sieraczynski-lab/Williamson-KT88/docs/01-lampy-kt88.md

# Lampy KT88 Psvane: serie i różnice

Elektrycznie wszystkie Psvane KT88 to wciąż KT88: anoda do ok. 35–42 W, napięcie anodowe do 800 V, żarzenie 6,3 V / 1,6 A. Pasują do tego samego układu bez przeliczania. Różnią się konstrukcją, selekcją, wyglądem i ceną. Psvane wywodzi się z działu lamp high-end fabryki Shuguang (seria Black Treasure to też Shuguang).

## Serie, od najtańszej do najdroższej (orientacyjnie)

| Seria | Co to jest | Cena orientacyjna |
|---|---|---|
| **AIR KT88** | najnowsza, budżetowa | ok. 70 € / szt. (Audiophonics) |
| **KT88 / KT88C Classic** | podstawowa wersja Hi-Fi | – |
| **KT88-T / KT88-TII (Mark II)** | szara powłoka węglowa wewnątrz bańki, teflonowy cokół z aluminiowym pierścieniem, grubsze szkło (ok. 10% cięższa) | ok. 449 € za dobrany kwartet |
| **UK-KT88** | wygląd nawiązujący do klasycznych GEC/Genalex | – |
| **Art (np. KT88-T3, ART TIII)** | średnio-wysoka półka | – |
| **Cossor KT88-R** | seria „retro”, też z niebieskawym szkłem | ok. 170 USD za parę, 340 USD za kwartet (eBay, sprzedawcy z Chin) |
| **ACME KT88** | były flagowiec: selekcja 3–5% najlepszych z partii, min. 24 h wygrzewania, ceramiczny cokół, złocone piny | ok. 119 CHF / szt. |
| **Summit KT88** | obecny flagowiec, wielowarstwowa powłoka katody HPC | ok. 655 USD za kwartet |

Opinie brzmieniowe (np. ACME „neutralna, dynamiczna”, ART TIII w 6SN7 „bardziej przytłumiona niż Summit”) pochodzą z pojedynczych recenzji i forów. Traktować je jako subiektywne.

## Niezawodność

Na forach (WhatsBestForum, Audiogon) są pojedyncze relacje o awariach: KT88C po 3 tygodniach, TII po 400 godzinach. To anegdoty, nie statystyka, ale wyższa seria nie gwarantuje automatycznie trwałości. Lepiej kupować u dealera z gwarancją i realnym parowaniem. Na eBayu od przypadkowych sprzedawców jest ryzyko podróbek.

## Wnioski dla projektu

- Do pierwszego uruchomienia i strojenia wziąć tańszą serię (AIR, Classic, TII). Podczas szukania oscylacji i ustawiania biasu lampy dostają w kość.
- Kupować **parę dobraną fabrycznie** (po dwie na kanał). Przy toroidzie i tak potrzebna jest osobna regulacja biasu każdej lampy.
- Droższe serie (Summit, ACME, Cossor) porównywać dopiero na dostrojonym wzmacniaczu. Wtedy różnice będą wynikały z lamp, a nie z układu.
