sieraczynski-lab/Williamson-KT88/obudowa/widok_plytka.png

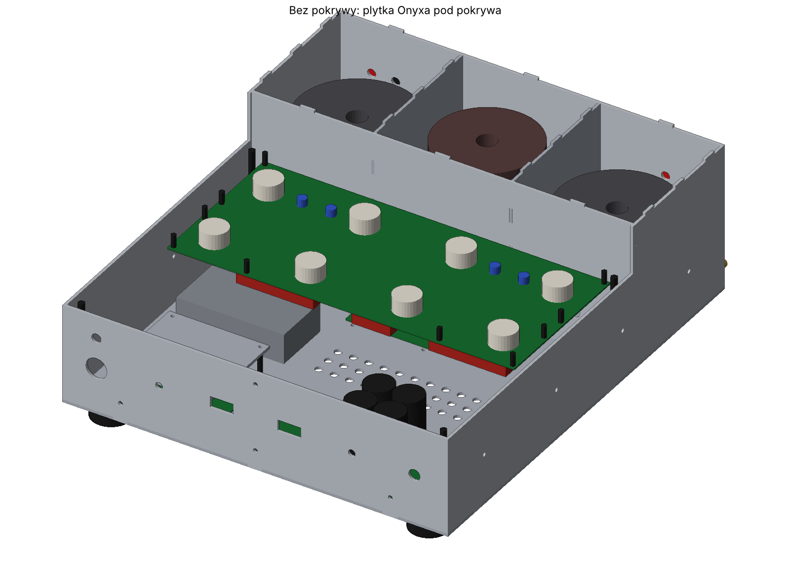
obudowa/widok_plytka.png
