sieraczynski-lab/Williamson-KT88/obudowa/widok_tyl.png

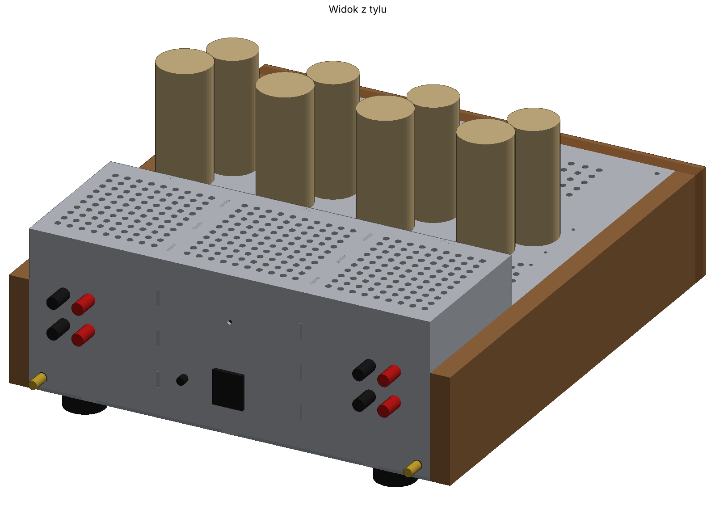
obudowa/widok_tyl.png
