sieraczynski-lab/Williamson-KT88/obudowa/widok_wnetrze.png

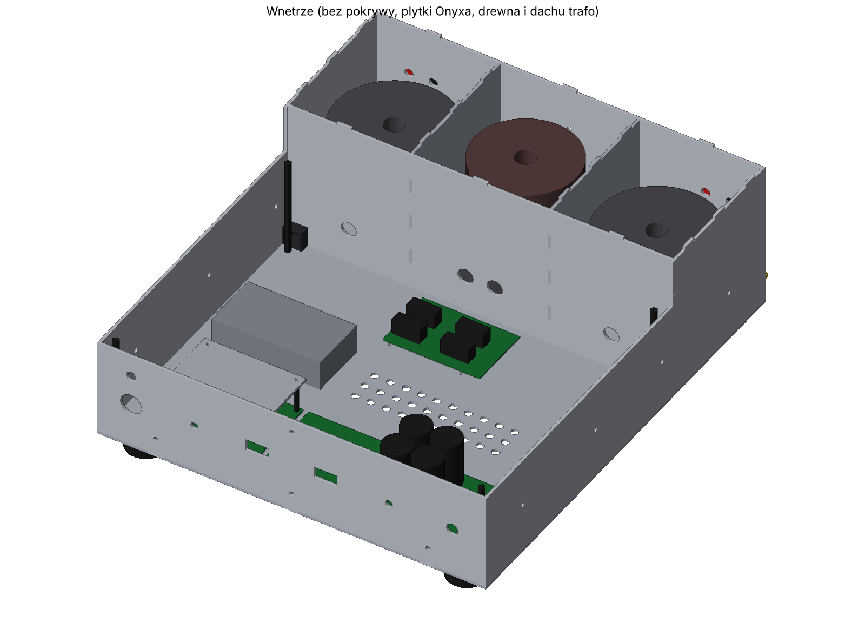
obudowa/widok_wnetrze.png
