sieraczynski-lab/Williamson-KT88/pcb/glosniki/glosniki_rozmieszczenie.png

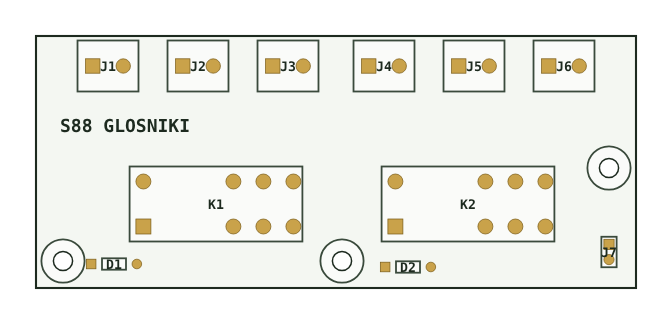
pcb/glosniki/glosniki_rozmieszczenie.png
