sieraczynski-lab/Williamson-KT88/pcb/sterowanie/sterowanie_rozmieszczenie.png

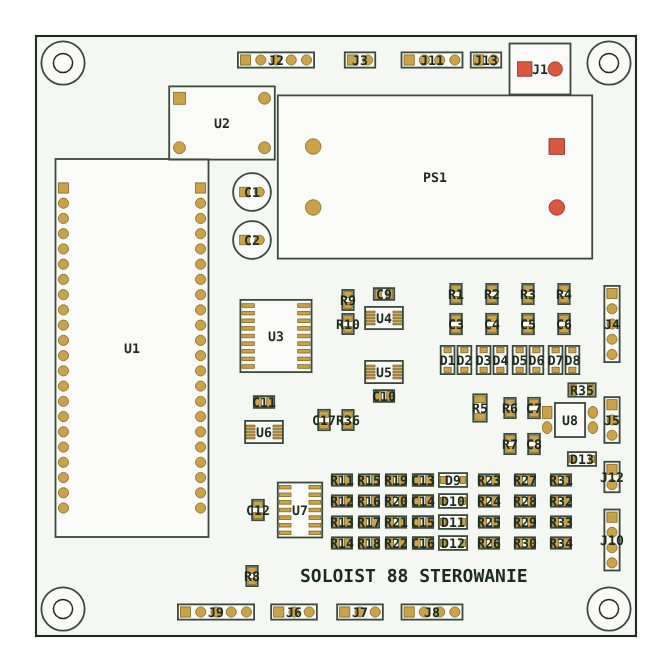
pcb/sterowanie/sterowanie_rozmieszczenie.png
