sieraczynski-lab/Williamson-KT88/pcb/ul/ul_trioda_williamson_rozmieszczenie.png

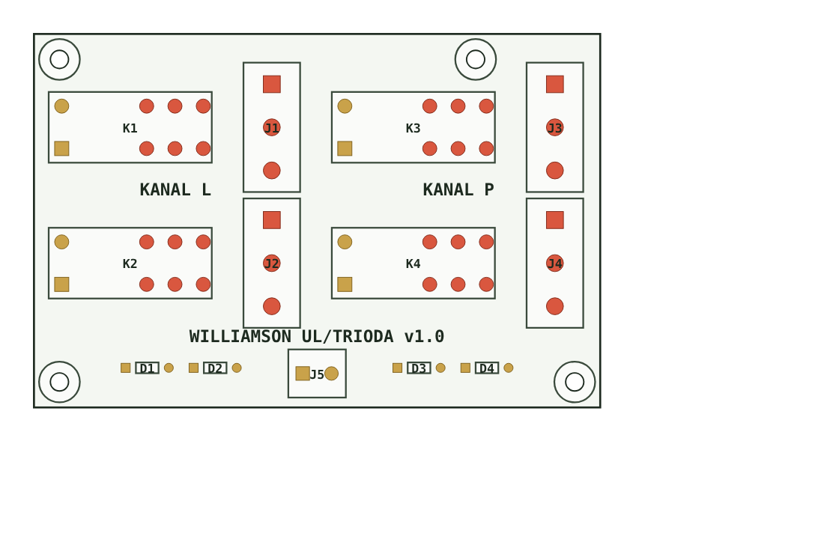
pcb/ul/ul_trioda_williamson_rozmieszczenie.png
