sieraczynski-lab/Williamson-KT88/pcb/ul/ul_trioda_williamson_schemat.png

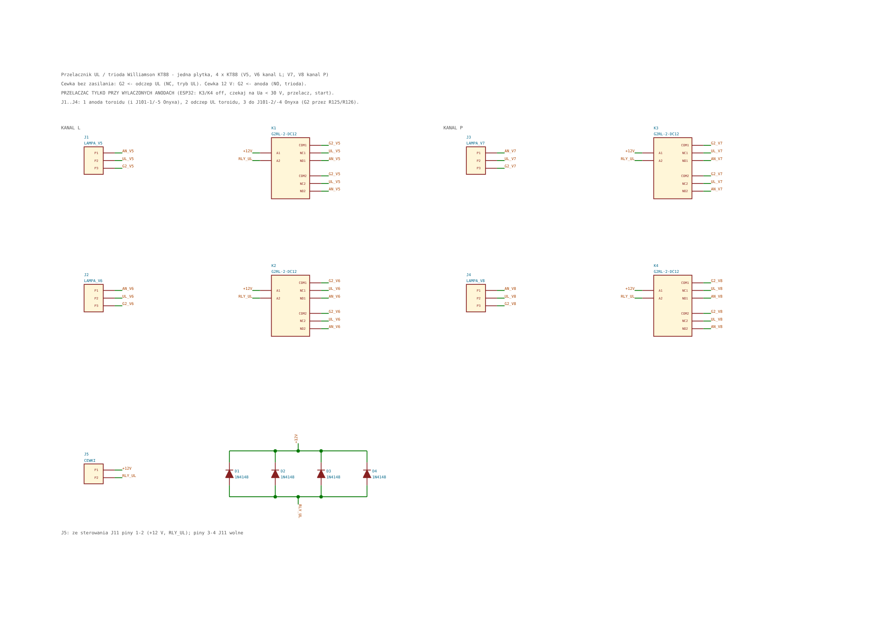
pcb/ul/ul_trioda_williamson_schemat.png
