sieraczynski-lab/Williamson-KT88/pcb/zasilacz/zasilacz_williamson_schemat.png

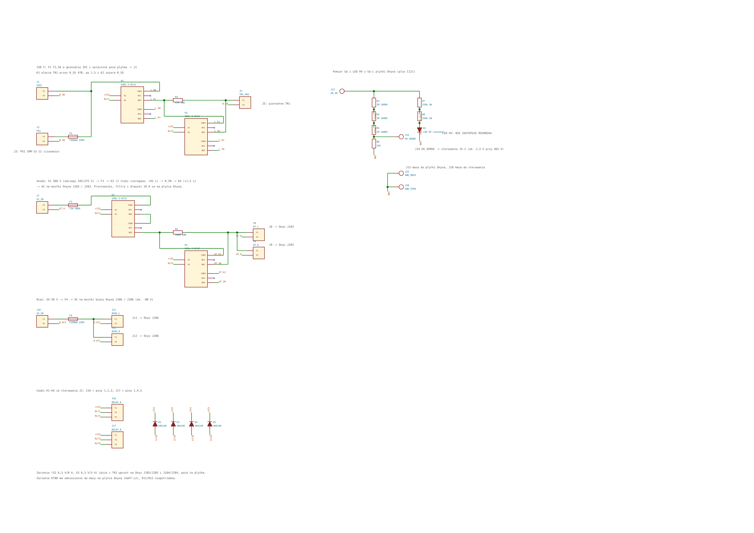
pcb/zasilacz/zasilacz_williamson_schemat.png
