sieraczynski-lab/Williamson-KT88/pcb/glosniki/glosniki_BOM_LCSC.xlsx

Soloist 88 - BOM plytki glosniki (x1) - elementy przewlekane
Czesci wybrane z czesci DOSTEPNYCH na magazynie wg bazy katalogu JLCPCB/LCSC z 25.10.2026 (kolumna Stan). Wiersze na pomaranczowo = brak w LCSC, kup w TME / sklepie lampowym. Minimalne ilosci sprawdz w koszyku.
Lp | Oznaczenia | Ilosc na plytke | Liczba plytek | Ilosc razem | Opis / parametry | Obudowa / raster | Producent | MPN | LCSC | Stan mag. (25.10) | Uwagi / gdzie kupic
1 | D1, D2 | 2 | 1 | 2 | Dioda 1N4148 | DO-35 |  | 1N4148 | C402212 | 162903
2 | J1, J2, J3, J4, J5, J6 | 6 | 1 | 6 | Zlacze srubowe 2-pin 5,08 mm |  | KEFA | KF128-5.08-2P-AA | C474952 | 62181
3 | K1, K2 | 2 | 1 | 2 | Przekaznik Omron G2RL-2 12 V DPDT 8 A | 29 x 12,7 mm |  | G2RL-2-DC12 | C61458 | 1258 | przed zamowieniem plytek sprawdz piny (CZYTAJ_MNIE)
4 | listwy proste (2 pin) | 1 | 1 | 1 | Listwa kolkowa prosta 1x40, 2,54 mm (do ciecia) | 2,54 mm |  | 2.54-1*40P | C2337 | 73249 | potrzeba 2 pinow + wtyki
