sieraczynski-lab/Williamson-KT88/obudowa/DXF/AL_dno_400x460x3.dxf

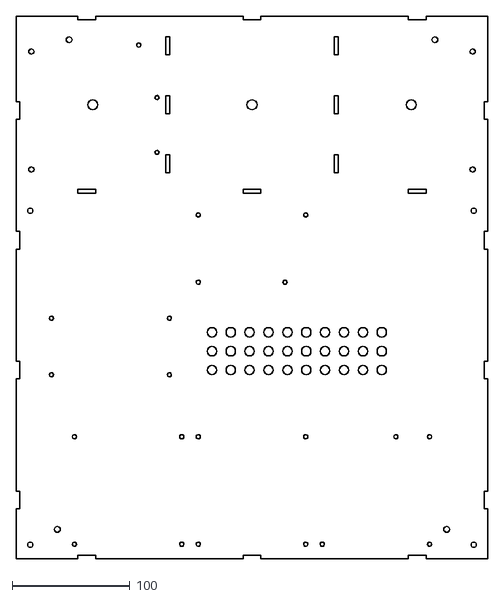
[picture p14: CAD file, 2026-11-13]
obudowa/DXF/AL_dno_400x460x3.dxf
400.0 x 460.0
