sieraczynski-lab/Williamson-KT88/obudowa/Williamson_obudowa_z_elementami.step

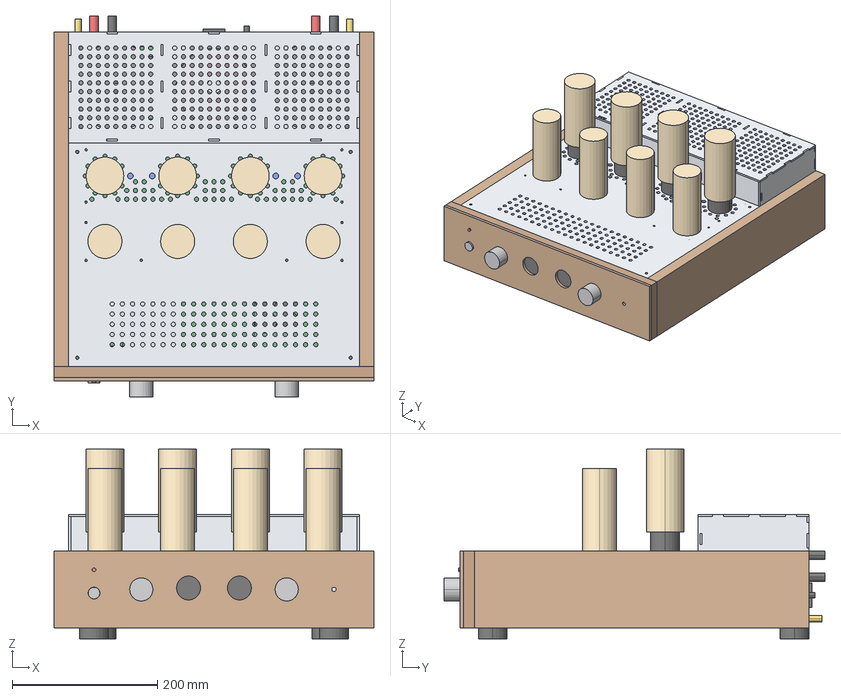
[picture p15: CAD file, 2026-11-13]
obudowa/Williamson_obudowa_z_elementami.step
440.0 x 524.0 x 261.0 mm
AL_dno_400x460x3
AL_bok_lewy
AL_bok_prawy
AL_przod_wewn
AL_trafo_przod
AL_trafo_tyl
AL_trafo_przegroda_L
AL_trafo_przegroda_P
AL_trafo_dach
AL_pokrywa_gorna
ST_profil_20x20x1.5_L_dl157
ST_profil_20x20x1.5_P_dl157
AL_ekran_sterowania
DREWNO_front_lico_5mm
DREWNO_front_rama_15mm
DREWNO_bok_lewy
DREWNO_bok_prawy
REF_plytka_Onyx_VA1523
REF_tuleja_M3_13mm x 10
REF_podstawka_oktal x 8
REF_KT88_cokol x 4
REF_KT88_banka x 4
REF_V1_L_6SN7_butelka
REF_V2_L_6SN7_butelka
REF_V2_R_6SN7_butelka
REF_V1_R_6SN7_butelka
REF_kondensatory_pod_plytka_0
REF_kondensatory_pod_plytka_1
REF_kondensatory_pod_plytka_2
REF_kondensatory_pod_plytka_3
REF_kondensatory_pod_plytka_4
REF_potencjometr_biasu x 4
REF_plytka_UL_LP
REF_przekaznik_G2RL_UL x 4
REF_selektor_puszka_1590
REF_plytka_sterowanie
REF_plytka_zasilacz_siec
REF_plytka_zasilacz_hv
REF_C_snapin_0
REF_C_snapin_1
REF_C_snapin_2
REF_C_snapin_3
REF_OT_L
REF_tuleja_TG_35mm x 2
REF_TR1
REF_OT_R
REF_gniazdo_RCA x 2
REF_tulejka_M3_ekran x 4
REF_dlawik_L1
REF_tulejka_M4_100mm x 4
REF_noga x 4
REF_galka x 2
REF_przycisk
REF_LED_2kol
REF_wyswietlacz_okragly x 2
REF_zacisk_glosnikowy x 8
REF_gniazdo_trigger_3.5mm
REF_plytka_glosniki
REF_przekaznik_G2RL x 2
REF_gniazdo_IEC
