sieraczynski-lab/Williamson-KT88/obudowa/DXF/AL_pokrywa_gorna.dxf

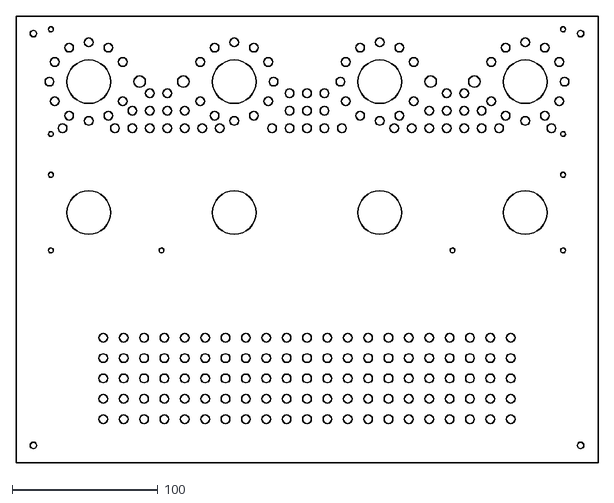
[picture p16: CAD file, 2026-11-12]
obudowa/DXF/AL_pokrywa_gorna.dxf
400.0 x 307.0
