sieraczynski-lab/Williamson-KT88/obudowa/Williamson_obudowa.step

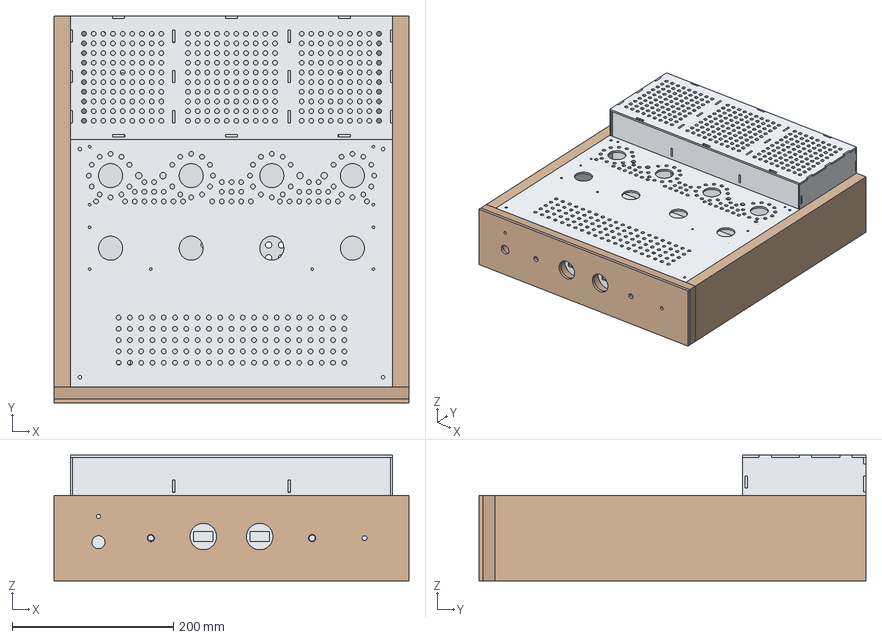
[picture p17: CAD file, 2026-11-13]
obudowa/Williamson_obudowa.step
440.0 x 480.0 x 156.0 mm
AL_dno_400x460x3
AL_bok_lewy
AL_bok_prawy
AL_przod_wewn
AL_trafo_przod
AL_trafo_tyl
AL_trafo_przegroda_L
AL_trafo_przegroda_P
AL_trafo_dach
AL_pokrywa_gorna
ST_profil_20x20x1.5_L_dl157
ST_profil_20x20x1.5_P_dl157
AL_ekran_sterowania
DREWNO_front_lico_5mm
DREWNO_front_rama_15mm
DREWNO_bok_lewy
DREWNO_bok_prawy
