sieraczynski-lab/Williamson-KT88/obudowa/DXF/AL_trafo_tyl.dxf

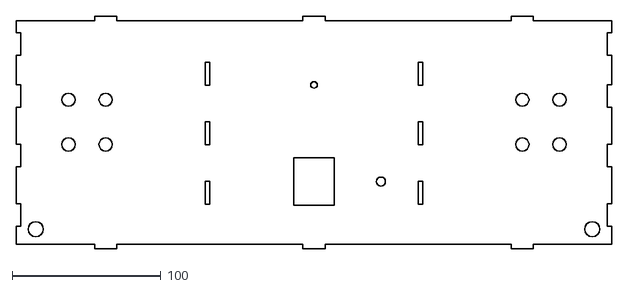
[picture p18: CAD file, 2026-11-12]
obudowa/DXF/AL_trafo_tyl.dxf
400.0 x 156.0
