sieraczynski-lab/Williamson-KT88/obudowa/DXF/AL_trafo_przegroda_L.dxf

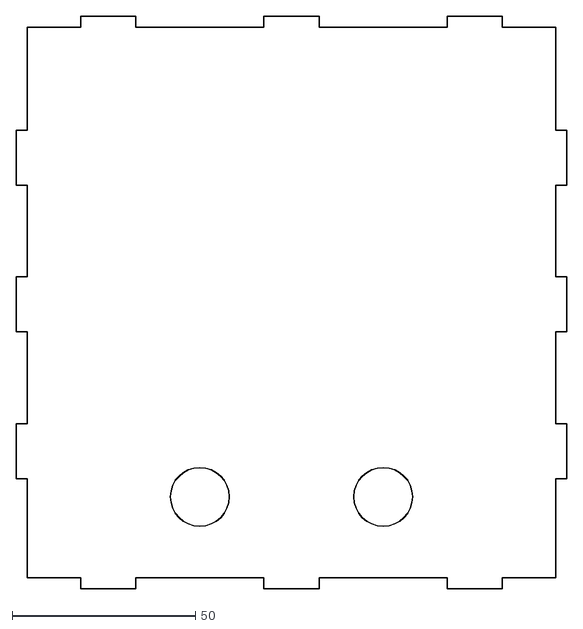
[picture p19: CAD file, 2026-11-12]
obudowa/DXF/AL_trafo_przegroda_L.dxf
150.0 x 156.0
