sieraczynski-lab/Williamson-KT88/obudowa/DXF/DREWNO_front_lico_5mm.dxf

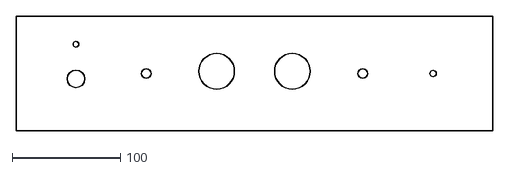
[picture p20: CAD file, 2026-11-12]
obudowa/DXF/DREWNO_front_lico_5mm.dxf
440.0 x 106.0
