sieraczynski-lab/Williamson-KT88/obudowa/DXF/AL_ekran_sterowania.dxf

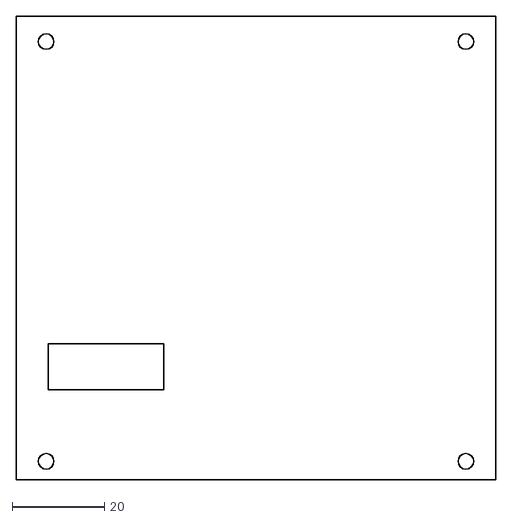
[picture p21: CAD file, 2026-11-12]
obudowa/DXF/AL_ekran_sterowania.dxf
104.0 x 100.5
