sieraczynski-lab/Williamson-KT88/obudowa/DXF/DREWNO_bok_lewy.dxf

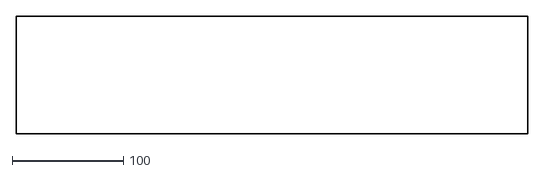
[picture p22: CAD file, 2026-11-12]
obudowa/DXF/DREWNO_bok_lewy.dxf
460.0 x 106.0
