sieraczynski-lab/Williamson-KT88/obudowa/DXF/AL_trafo_dach.dxf

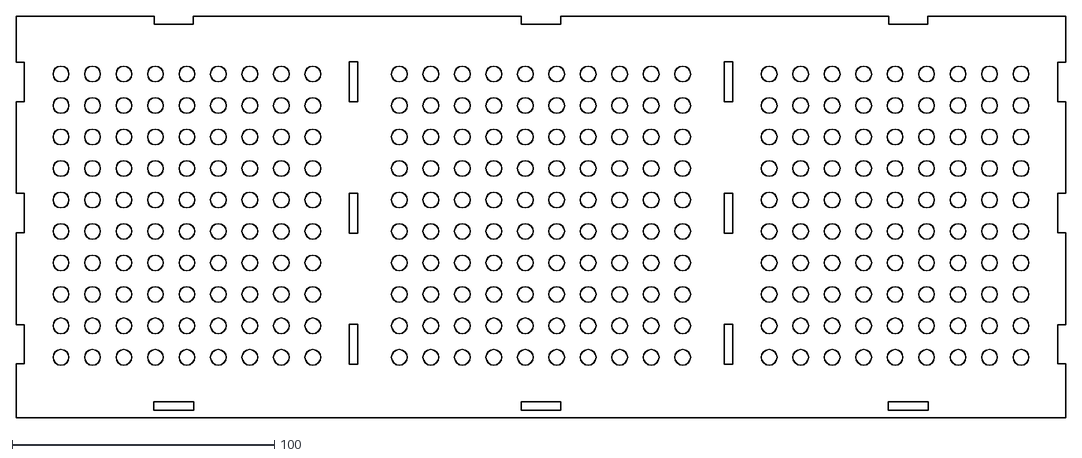
[picture p23: CAD file, 2026-11-12]
obudowa/DXF/AL_trafo_dach.dxf
400.0 x 153.0
