sieraczynski-lab/Williamson-KT88/obudowa/DXF/AL_przod_wewn.dxf

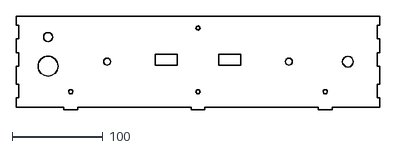
[picture p24: CAD file, 2026-11-12]
obudowa/DXF/AL_przod_wewn.dxf
400.0 x 103.0
