sieraczynski-lab/Williamson-KT88/obudowa/DXF/AL_bok_prawy.dxf

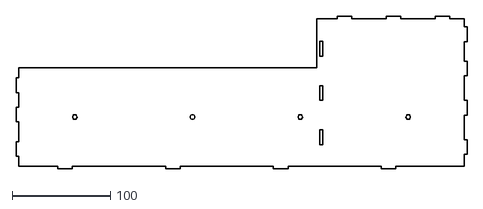
[picture p25: CAD file, 2026-11-12]
obudowa/DXF/AL_bok_prawy.dxf
460.0 x 156.0
