sieraczynski-lab/Williamson-KT88/obudowa/DXF/AL_trafo_przod.dxf

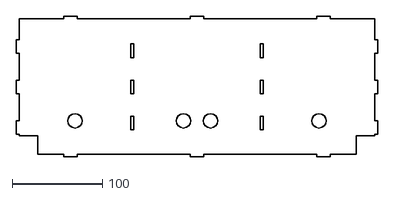
[picture p26: CAD file, 2026-11-12]
obudowa/DXF/AL_trafo_przod.dxf
400.0 x 156.0
