sieraczynski-lab/Williamson-KT88/obudowa/DXF/DREWNO_front_rama_15mm.dxf

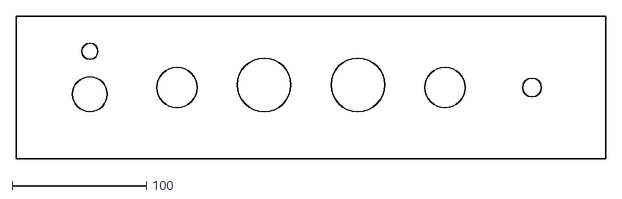
[picture p27: CAD file, 2026-11-12]
obudowa/DXF/DREWNO_front_rama_15mm.dxf
440.0 x 106.0
