sieraczynski-lab/Williamson-KT88/pcb/glosniki/glosniki_rozmieszczenie_1do1.pdf

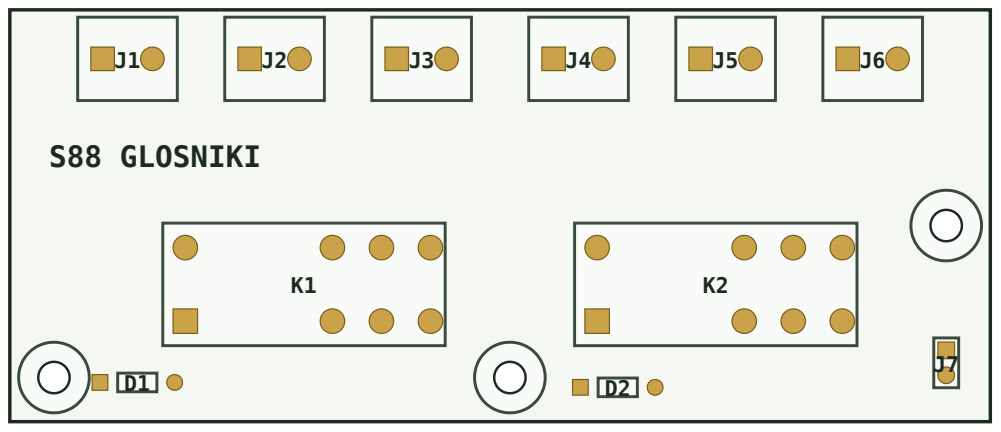
[picture p28: page 1]
