sieraczynski-lab/Williamson-KT88/pcb/sterowanie/sterowanie_rozmieszczenie_1do1.pdf

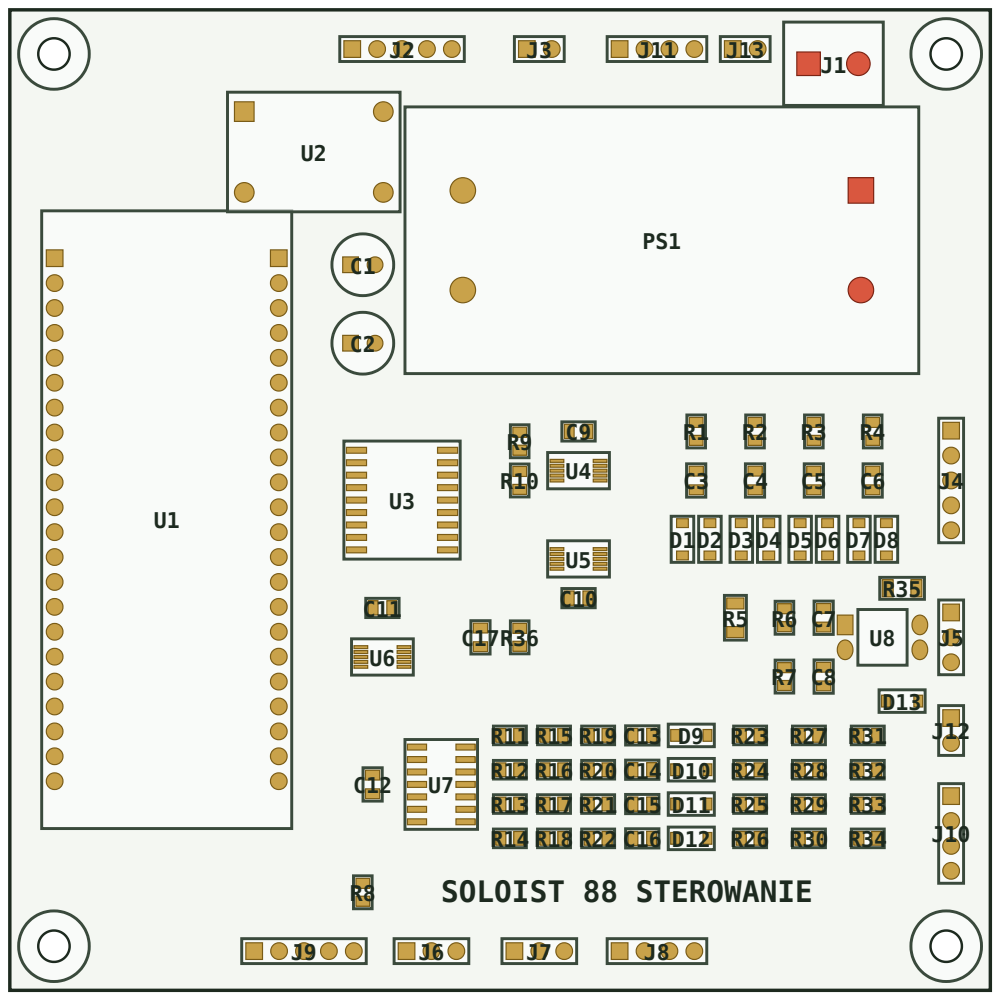
[picture p29: page 1]
