sieraczynski-lab/Williamson-KT88/pcb/ul/KiCad5_dla_EasyEDA_Pro_i_KiCad8/ul_trioda_williamson.kicad_pcb

## KiCad design pcb/ul/KiCad5_dla_EasyEDA_Pro_i_KiCad8/ul_trioda_williamson.kicad_pcb (2026-11-13)

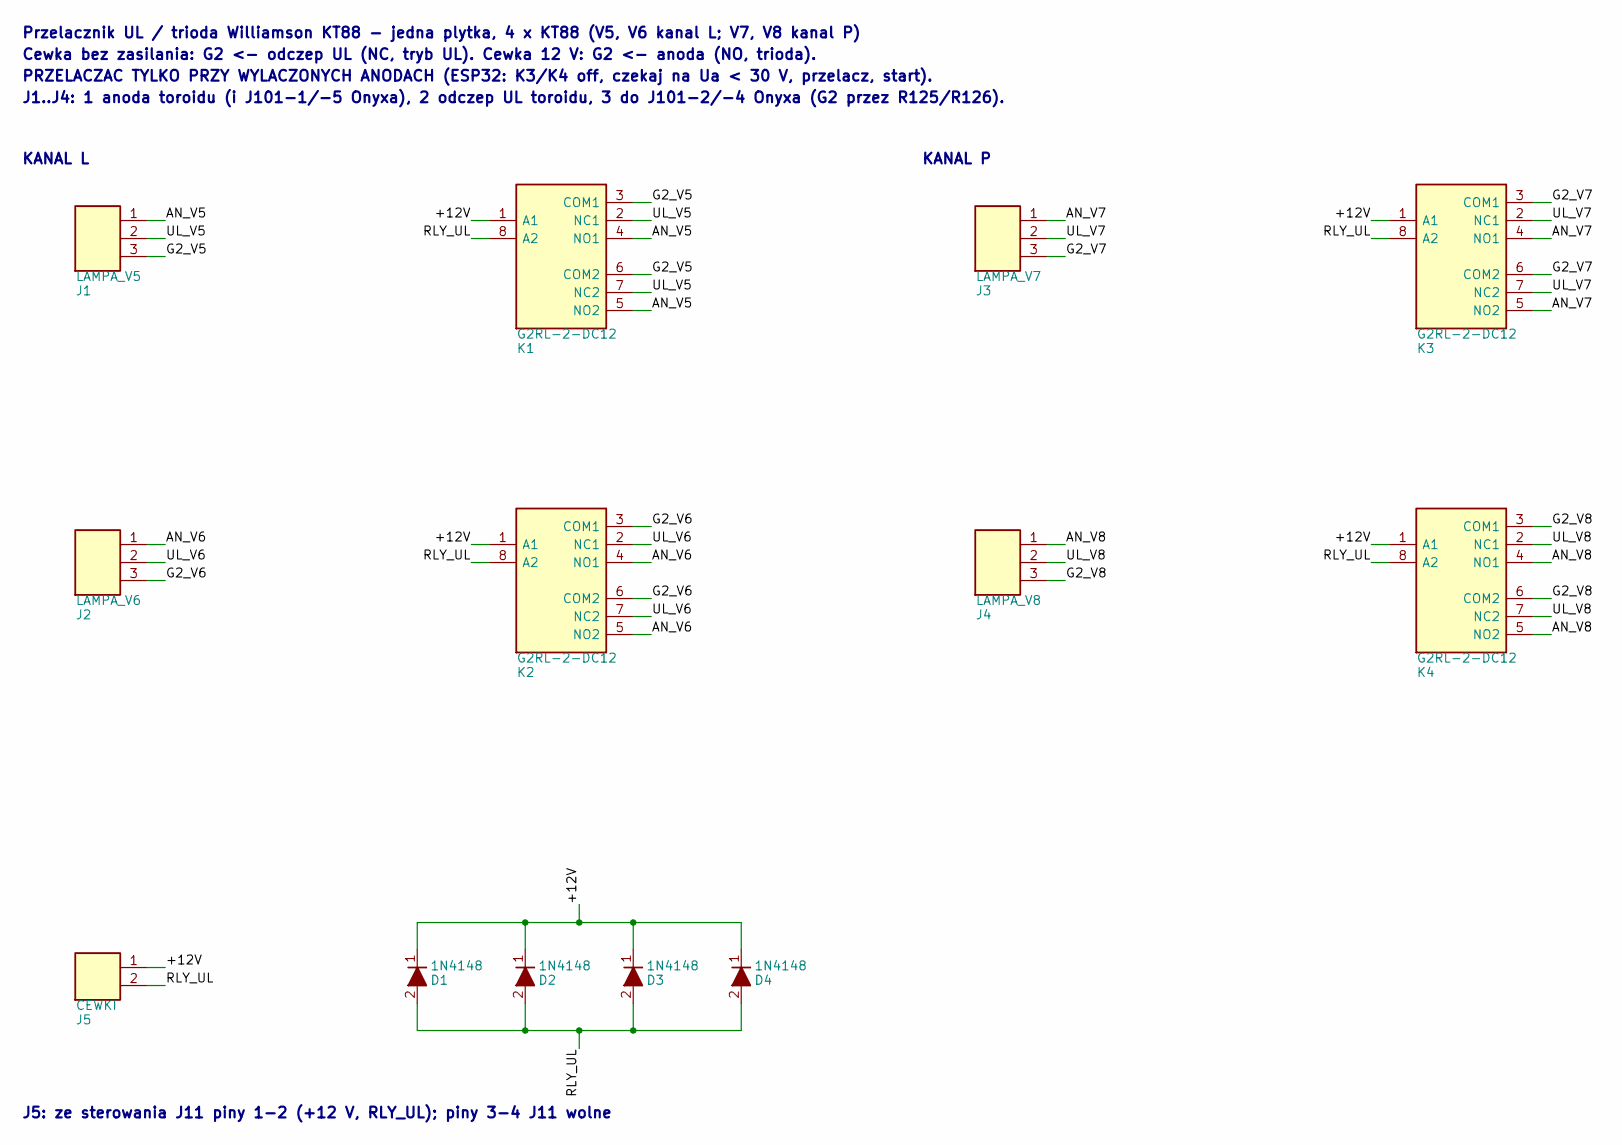
[picture p30: schematic ul_trioda_williamson.sch, Williamson KT88 - przelacznik UL/trioda, 4x KT88 na jednej …]

Parts:
D1, D2, D3, D4: 1N4148; D_DO-35_P7.62
J1: LAMPA_V5; TerminalBlock_1x03_P7.62_V
J2: LAMPA_V6; TerminalBlock_1x03_P7.62_V
J3: LAMPA_V7; TerminalBlock_1x03_P7.62_V
J4: LAMPA_V8; TerminalBlock_1x03_P7.62_V
J5: CEWKI; TerminalBlock_1x02_P5.08
K1, K2, K3, K4: G2RL-2-DC12; Relay_DPDT_Omron_G2RL

Connections:
+12V: D1.1 (K), D2.1 (K), D3.1 (K), D4.1 (K), J5.1, K1.1 (A1), K2.1 (A1), K3.1 (A1), K4.1 (A1)
AN_V5: J1.1, K1.4 (NO1), K1.5 (NO2)
AN_V6: J2.1, K2.4 (NO1), K2.5 (NO2)
AN_V7: J3.1, K3.4 (NO1), K3.5 (NO2)
AN_V8: J4.1, K4.4 (NO1), K4.5 (NO2)
G2_V5: J1.3, K1.3 (COM1), K1.6 (COM2)
G2_V6: J2.3, K2.3 (COM1), K2.6 (COM2)
G2_V7: J3.3, K3.3 (COM1), K3.6 (COM2)
G2_V8: J4.3, K4.3 (COM1), K4.6 (COM2)
RLY_UL: D1.2 (A), D2.2 (A), D3.2 (A), D4.2 (A), J5.2, K1.8 (A2), K2.8 (A2), K3.8 (A2), K4.8 (A2)
UL_V5: J1.2, K1.2 (NC1), K1.7 (NC2)
UL_V6: J2.2, K2.2 (NC1), K2.7 (NC2)
UL_V7: J3.2, K3.2 (NC1), K3.7 (NC2)
UL_V8: J4.2, K4.2 (NC1), K4.7 (NC2)

Notes on the sheet:
Przelacznik UL / trioda Williamson KT88 - jedna plytka, 4 x KT88 (V5, V6 kanal L; V7, V8 kanal P)
Cewka bez zasilania: G2 <- odczep UL (NC, tryb UL). Cewka 12 V: G2 <- anoda (NO, trioda).
PRZELACZAC TYLKO PRZY WYLACZONYCH ANODACH (ESP32: K3/K4 off, czekaj na Ua < 30 V, przelacz, start).
J1..J4: 1 anoda toroidu (i J101-1/-5 Onyxa), 2 odczep UL toroidu, 3 do J101-2/-4 Onyxa (G2 przez R125/R126).
KANAL L
KANAL P
J5: ze sterowania J11 piny 1-2 (+12 V, RLY_UL); piny 3-4 J11 wolne

Board: 2 copper layers, 17 parts (0 on the bottom side), 14 nets, no tracks yet.

Other parts of the board:
MH1, MH2, MH3, MH4: M3; MountingHole_M3
