sieraczynski-lab/Williamson-KT88/pcb/zasilacz/KiCad4_dla_EasyEDA_Standard/zasilacz_williamson.kicad_pcb

## KiCad design pcb/zasilacz/KiCad4_dla_EasyEDA_Standard/zasilacz_williamson.kicad_pcb (2026-11-12)

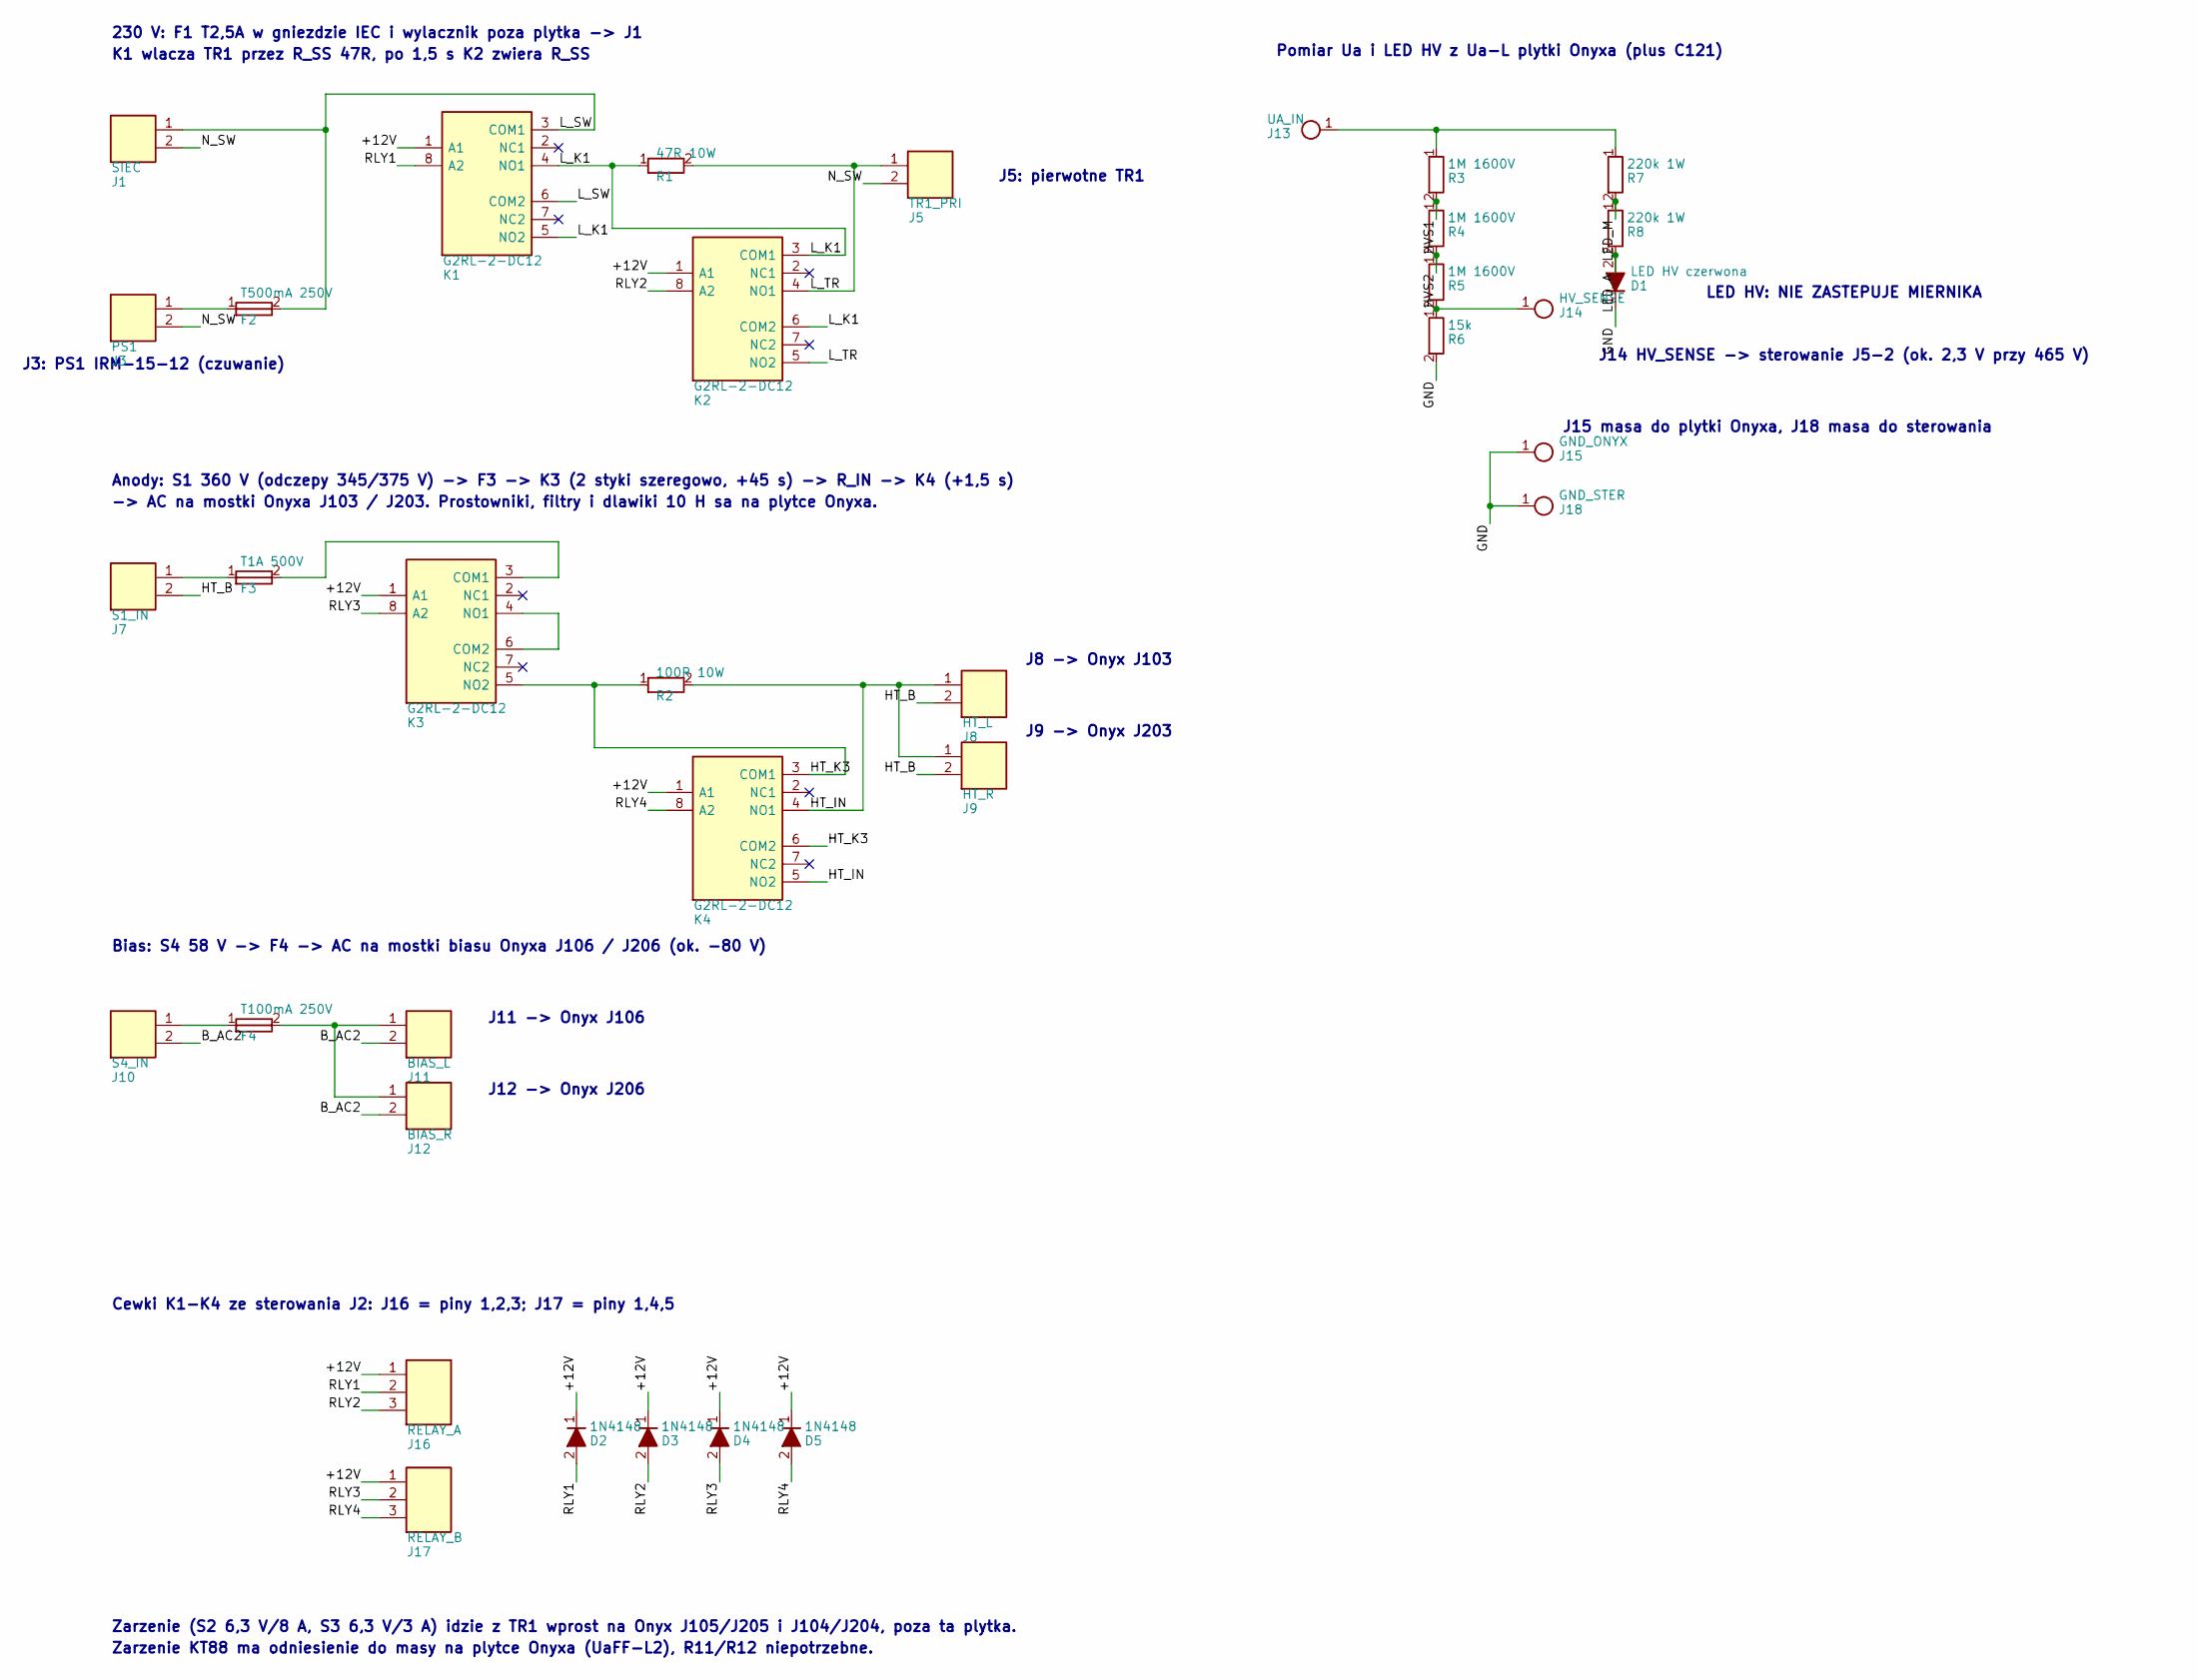
[picture p31: schematic zasilacz_williamson.sch, Williamson KT88 - plytka zasilacza (siec, opoznienie anod, …]

Parts:
D1: LED HV czerwona; LED_D3.0_P2.54
D2, D3, D4, D5: 1N4148; D_DO-35_P7.62_V
F2: T500mA 250V; Fuseholder_5x20_Closed_P22.5
F3: T1A 500V; Fuseholder_5x20_Closed_P22.5_V
F4: T100mA 250V; Fuseholder_5x20_Closed_P22.5
J1: SIEC; TerminalBlock_1x02_P5.08_V
J3: PS1; TerminalBlock_1x02_P5.08_V
J5: TR1_PRI; TerminalBlock_1x02_P5.08_V
J7: S1_IN; TerminalBlock_1x02_P7.62_V
J8: HT_L; TerminalBlock_1x02_P7.62_V
J9: HT_R; TerminalBlock_1x02_P7.62_V
J10: S4_IN; TerminalBlock_1x02_P5.08_V
J11: BIAS_L; TerminalBlock_1x02_P5.08
J12: BIAS_R; TerminalBlock_1x02_P5.08
J13: UA_IN; WirePad_4.5
J14: HV_SENSE; WirePad_3.5
J15: GND_ONYX; WirePad_4.5
J16: RELAY_A; PinHeader_1x03_P2.54
J17: RELAY_B; PinHeader_1x03_P2.54
J18: GND_STER; WirePad_3.5
K1, K2, K3, K4: G2RL-2-DC12; Relay_DPDT_Omron_G2RL
R1: 47R 10W; R_Cement_10W_P55.88_V
R2: 100R 10W; R_Cement_10W_P55.88_V
R3, R4, R5: 1M 1600V; R_Axial_1W_P15.24_V
R6: 15k; R_Axial_0.5W_P12.7_V
R7, R8: 220k 1W; R_Axial_1W_P15.24_V

Connections:
+12V: D2.1 (K), D3.1 (K), D4.1 (K), D5.1 (K), J16.1, J17.1, K1.1 (A1), K2.1 (A1), K3.1 (A1), K4.1 (A1)
B_AC1: F4.1, J10.1
B_AC2: J10.2, J11.2, J12.2
B_F: F4.2, J11.1, J12.1
GND: D1.1 (K), J15.1, J18.1, R6.2
HT_B: J7.2, J8.2, J9.2
HT_F: F3.2, K3.3 (COM1)
HT_IN: J8.1, J9.1, K4.4 (NO1), K4.5 (NO2), R2.2
HT_K3: K3.5 (NO2), K4.3 (COM1), K4.6 (COM2), R2.1
HT_TR: F3.1, J7.1
HVS1: R3.2, R4.1
HVS2: R4.2, R5.1
HV_SENSE: J14.1, R5.2, R6.1
K3_MID: K3.4 (NO1), K3.6 (COM2)
LED_A: D1.2 (A), R8.2
LED_M: R7.2, R8.1
L_K1: K1.4 (NO1), K1.5 (NO2), K2.3 (COM1), K2.6 (COM2), R1.1
L_SW: F2.2, J1.1, K1.3 (COM1), K1.6 (COM2)
L_TR: J5.1, K2.4 (NO1), K2.5 (NO2), R1.2
L_TR2: F2.1, J3.1
N_SW: J1.2, J3.2, J5.2
RLY1: D2.2 (A), J16.2, K1.8 (A2)
RLY2: D3.2 (A), J16.3, K2.8 (A2)
RLY3: D4.2 (A), J17.2, K3.8 (A2)
RLY4: D5.2 (A), J17.3, K4.8 (A2)
UA: J13.1, R3.1, R7.1

Notes on the sheet:
230 V: F1 T2,5A w gniezdzie IEC i wylacznik poza plytka -> J1
K1 wlacza TR1 przez R_SS 47R, po 1,5 s K2 zwiera R_SS
J5: pierwotne TR1
J3: PS1 IRM-15-12 (czuwanie)
Anody: S1 360 V (odczepy 345/375 V) -> F3 -> K3 (2 styki szeregowo, +45 s) -> R_IN -> K4 (+1,5 s)
-> AC na mostki Onyxa J103 / J203. Prostowniki, filtry i dlawiki 10 H sa na plytce Onyxa.
J8 -> Onyx J103
J9 -> Onyx J203
Bias: S4 58 V -> F4 -> AC na mostki biasu Onyxa J106 / J206 (ok. -80 V)
J11 -> Onyx J106
J12 -> Onyx J206
Pomiar Ua i LED HV z Ua-L plytki Onyxa (plus C121)
J14 HV_SENSE -> sterowanie J5-2 (ok. 2,3 V przy 465 V)
J15 masa do plytki Onyxa, J18 masa do sterowania
LED HV: NIE ZASTEPUJE MIERNIKA
Cewki K1-K4 ze sterowania J2: J16 = piny 1,2,3; J17 = piny 1,4,5
Zarzenie (S2 6,3 V/8 A, S3 6,3 V/3 A) idzie z TR1 wprost na Onyx J105/J205 i J104/J204, poza ta plytka.
Zarzenie KT88 ma odniesienie do masy na plytce Onyxa (UaFF-L2), R11/R12 niepotrzebne.

Board: 2 copper layers, 39 parts (0 on the bottom side), 26 nets, no tracks yet.

Other parts of the board:
MH1, MH2, MH3, MH4: M3; MountingHole_M3
