sieraczynski-lab/Williamson-KT88/pcb/selektor/kicad/tube_selector.kicad_pcb

## KiCad design pcb/selektor/kicad/tube_selector.kicad_pcb (2026-11-12)

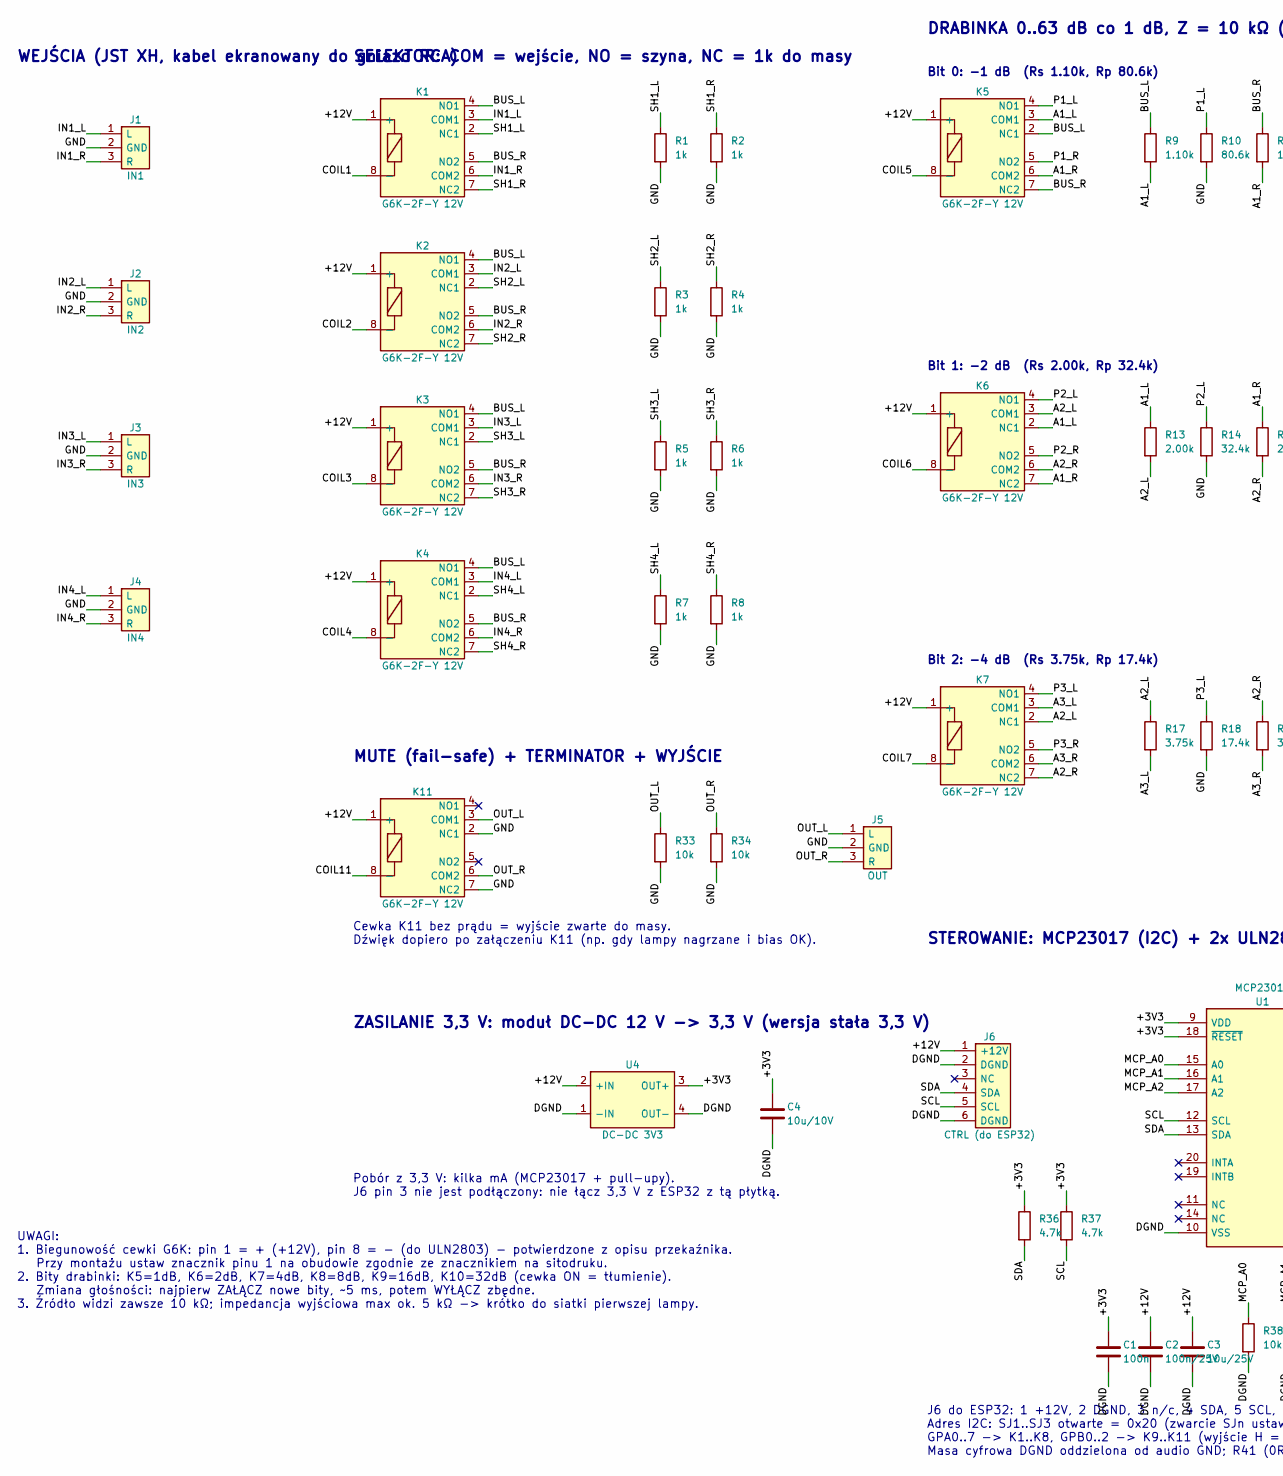
[picture p33: schematic tube_selector.kicad_sch, Selektor wejść + drabinka przekaźnikowa, part in row 1, column 1]

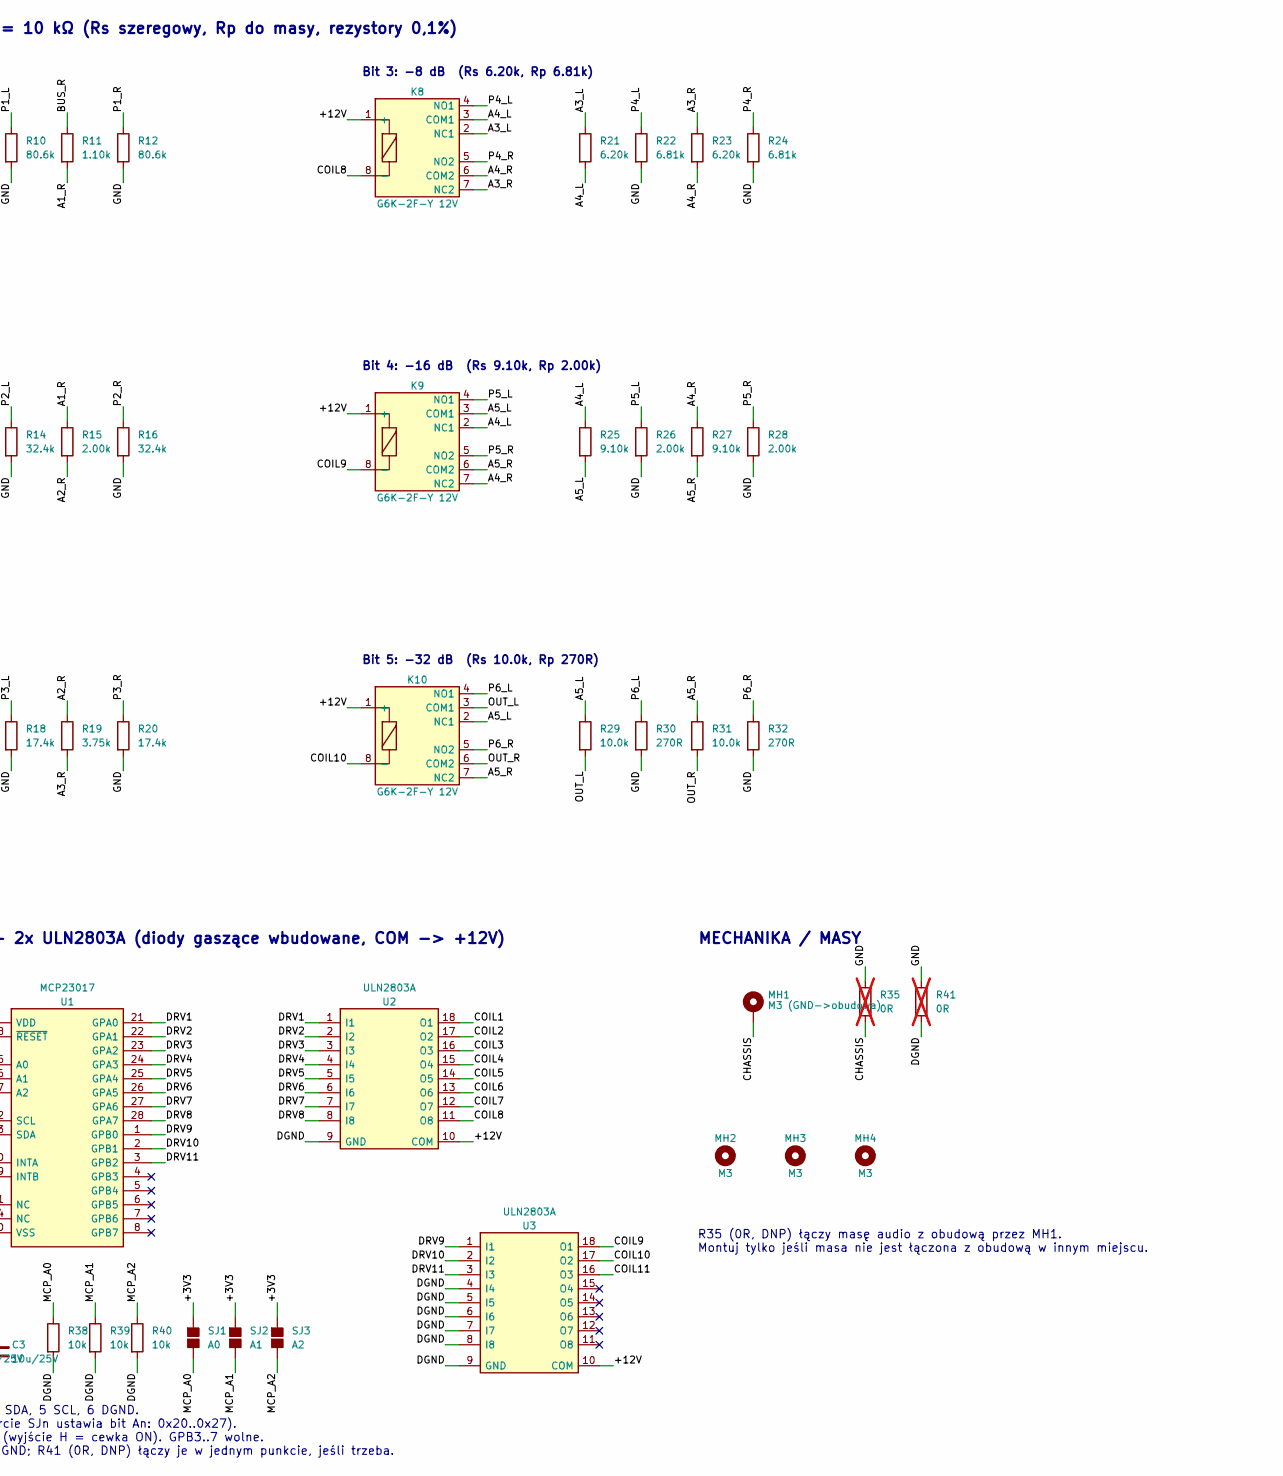
[picture p34: schematic tube_selector.kicad_sch, Selektor wejść + drabinka przekaźnikowa, part in row 1, column 2]

Parts:
C1: 100n; C_0805_2012Metric; MPN CC0805KRX7R9BB104; LCSC C49678
C2: 100n/25V; C_0805_2012Metric; MPN CC0805KRX7R9BB104; LCSC C49678
C3: 10u/25V; C_1206_3216Metric; MPN CL31A106KBHNNNE; LCSC C13585
C4: 10u/10V; C_1206_3216Metric; MPN CL31A106KBHNNNE; LCSC C13585
J1: IN1; JST_XH_B3B-XH-A_1x03_P2.50mm_Vertical
J2: IN2; JST_XH_B3B-XH-A_1x03_P2.50mm_Vertical
J3: IN3; JST_XH_B3B-XH-A_1x03_P2.50mm_Vertical
J4: IN4; JST_XH_B3B-XH-A_1x03_P2.50mm_Vertical
J5: OUT; JST_XH_B3B-XH-A_1x03_P2.50mm_Vertical
J6: CTRL (do ESP32); JST_XH_B6B-XH-A_1x06_P2.50mm_Vertical; MPN JST B6B-XH-A + wtyk XHP-6
K1, K2, K3, K4, K5, K6, K7, K8, K9, K10, K11: G6K-2F-Y 12V; Relay_DPDT_Omron_G6K-2F-Y; MPN G6K-2F-Y-TR DC12; LCSC C397192
MH1: M3 (GND->obudowa); MountingHole_3.2mm_M3_Pad
MH2, MH3, MH4: M3; MountingHole_3.2mm_M3
R1, R2, R3, R4, R5, R6, R7, R8: 1k; R_0805_2012Metric; Tolerancja 1%; MPN 0805W8F1001T5E; LCSC C17513
R9, R11: 1.10k; R_0805_2012Metric; Tolerancja 0.1%; MPN ERA6AEB112V; LCSC C473284
R10, R12: 80.6k; R_0805_2012Metric; Tolerancja 0.1%; MPN RT0805BRD0780K6L; LCSC C728657
R13, R15, R26, R28: 2.00k; R_0805_2012Metric; Tolerancja 0.1%; MPN PTFR0805B2K00P9; LCSC C479096
R14, R16: 32.4k; R_0805_2012Metric; Tolerancja 0.1%; MPN TR0805B32K4P0550Z; LCSC C149970
R17, R19: 3.75k; R_0805_2012Metric; Tolerancja 0.1%; MPN AR05BTB3751A010; LCSC C374641
R18, R20: 17.4k; R_0805_2012Metric; Tolerancja 0.1%; MPN PTFR0805B17K4P9; LCSC C47115938
R21, R23: 6.20k; R_0805_2012Metric; Tolerancja 0.1%; MPN RT0805BRD076K2L; LCSC C326695
R22, R24: 6.81k; R_0805_2012Metric; Tolerancja 0.1%; MPN RT0805BRD076K81L; LCSC C728655
R25, R27: 9.10k; R_0805_2012Metric; Tolerancja 0.1%; MPN TC0525B9101T5G; LCSC C21571502
R29, R31: 10.0k; R_0805_2012Metric; Tolerancja 0.1%; MPN RT0805BRD0710KL; LCSC C110775
R30, R32: 270R; R_0805_2012Metric; Tolerancja 0.1%; MPN PTFR0805B270RN9; LCSC C351587
R33, R34: 10k; R_0805_2012Metric; Tolerancja 0.1%; MPN RT0805BRD0710KL; LCSC C110775
R35, R41: 0R; R_0805_2012Metric; not fitted
R36, R37: 4.7k; R_0805_2012Metric; Tolerancja 1%; MPN 0805W8F4701T5E; LCSC C17673
R38, R39, R40: 10k; R_0805_2012Metric; Tolerancja 1%; MPN 0805W8F1002T5E; LCSC C17414
SJ1: A0; SolderJumper-2_P1.3mm_Open_Pad1.0x1.5mm
SJ2: A1; SolderJumper-2_P1.3mm_Open_Pad1.0x1.5mm
SJ3: A2; SolderJumper-2_P1.3mm_Open_Pad1.0x1.5mm
U1: MCP23017; SOIC-28W_7.5x17.9mm_P1.27mm; MPN MCP23017-E/SO; LCSC C47023
U2, U3: ULN2803A; SOIC-18W_7.5x11.6mm_P1.27mm; MPN ULN2803G-S18-R (UTC); LCSC C33924
U4: DC-DC 3V3; DCDC_Mini_4pin_14.17x8.24mm; MPN Mini DC-DC step-down 3,3 V (pinout: 1 -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

Connections:
/+3V3: C1.1, C4.1, R36.1, R37.1, SJ1.1, SJ2.1, SJ3.1, U1.9 (VDD), U1.18 (~RESET), U4.3 (OUT+)
/+12V: C2.1, C3.1, J6.1 (+12V), K1.1 (+), K2.1 (+), K3.1 (+), K4.1 (+), K5.1 (+), K6.1 (+), K7.1 (+), K8.1 (+), K9.1 (+), K10.1 (+), K11.1 (+), U2.10 (COM), U3.10 (COM), U4.2 (+IN)
/A1_L: K5.3 (COM1), K6.2 (NC1), R9.2, R13.1
/A1_R: K5.6 (COM2), K6.7 (NC2), R11.2, R15.1
/A2_L: K6.3 (COM1), K7.2 (NC1), R13.2, R17.1
/A2_R: K6.6 (COM2), K7.7 (NC2), R15.2, R19.1
/A3_L: K7.3 (COM1), K8.2 (NC1), R17.2, R21.1
/A3_R: K7.6 (COM2), K8.7 (NC2), R19.2, R23.1
/A4_L: K8.3 (COM1), K9.2 (NC1), R21.2, R25.1
/A4_R: K8.6 (COM2), K9.7 (NC2), R23.2, R27.1
/A5_L: K9.3 (COM1), K10.2 (NC1), R25.2, R29.1
/A5_R: K9.6 (COM2), K10.7 (NC2), R27.2, R31.1
/BUS_L: K1.4 (NO1), K2.4 (NO1), K3.4 (NO1), K4.4 (NO1), K5.2 (NC1), R9.1
/BUS_R: K1.5 (NO2), K2.5 (NO2), K3.5 (NO2), K4.5 (NO2), K5.7 (NC2), R11.1
/CHASSIS: MH1.1, R35.2
/COIL1: K1.8 (-), U2.18 (O1)
/COIL2: K2.8 (-), U2.17 (O2)
/COIL3: K3.8 (-), U2.16 (O3)
/COIL4: K4.8 (-), U2.15 (O4)
/COIL5: K5.8 (-), U2.14 (O5)
/COIL6: K6.8 (-), U2.13 (O6)
/COIL7: K7.8 (-), U2.12 (O7)
/COIL8: K8.8 (-), U2.11 (O8)
/COIL9: K9.8 (-), U3.18 (O1)
/COIL10: K10.8 (-), U3.17 (O2)
/COIL11: K11.8 (-), U3.16 (O3)
/DGND: C1.2, C2.2, C3.2, C4.2, J6.2 (DGND), J6.6 (DGND), R38.2, R39.2, R40.2, R41.2, U1.10 (VSS), U2.9 (GND), U3.4 (I4), U3.5 (I5), U3.6 (I6), U3.7 (I7), U3.8 (I8), U3.9 (GND), U4.1 (-IN), U4.4 (OUT-)
/DRV1: U1.21 (GPA0), U2.1 (I1)
/DRV2: U1.22 (GPA1), U2.2 (I2)
/DRV3: U1.23 (GPA2), U2.3 (I3)
/DRV4: U1.24 (GPA3), U2.4 (I4)
/DRV5: U1.25 (GPA4), U2.5 (I5)
/DRV6: U1.26 (GPA5), U2.6 (I6)
/DRV7: U1.27 (GPA6), U2.7 (I7)
/DRV8: U1.28 (GPA7), U2.8 (I8)
/DRV9: U1.1 (GPB0), U3.1 (I1)
/DRV10: U1.2 (GPB1), U3.2 (I2)
/DRV11: U1.3 (GPB2), U3.3 (I3)
/GND: J1.2 (GND), J2.2 (GND), J3.2 (GND), J4.2 (GND), J5.2 (GND), K11.2 (NC1), K11.7 (NC2), R1.2, R2.2, R3.2, R4.2, R5.2, R6.2, R7.2, R8.2, R10.2, R12.2, R14.2, R16.2, R18.2, R20.2, R22.2, R24.2, R26.2, R28.2, R30.2, R32.2, R33.2, R34.2, R35.1, R41.1
/IN1_L: J1.1 (L), K1.3 (COM1)
/IN1_R: J1.3 (R), K1.6 (COM2)
/IN2_L: J2.1 (L), K2.3 (COM1)
/IN2_R: J2.3 (R), K2.6 (COM2)
/IN3_L: J3.1 (L), K3.3 (COM1)
/IN3_R: J3.3 (R), K3.6 (COM2)
/IN4_L: J4.1 (L), K4.3 (COM1)
/IN4_R: J4.3 (R), K4.6 (COM2)
/MCP_A0: R38.1, SJ1.2, U1.15 (A0)
/MCP_A1: R39.1, SJ2.2, U1.16 (A1)
/MCP_A2: R40.1, SJ3.2, U1.17 (A2)
/OUT_L: J5.1 (L), K10.3 (COM1), K11.3 (COM1), R29.2, R33.1
/OUT_R: J5.3 (R), K10.6 (COM2), K11.6 (COM2), R31.2, R34.1
/P1_L: K5.4 (NO1), R10.1
/P1_R: K5.5 (NO2), R12.1
/P2_L: K6.4 (NO1), R14.1
/P2_R: K6.5 (NO2), R16.1
/P3_L: K7.4 (NO1), R18.1
/P3_R: K7.5 (NO2), R20.1
/P4_L: K8.4 (NO1), R22.1
/P4_R: K8.5 (NO2), R24.1
/P5_L: K9.4 (NO1), R26.1
/P5_R: K9.5 (NO2), R28.1
/P6_L: K10.4 (NO1), R30.1
/P6_R: K10.5 (NO2), R32.1
/SCL: J6.5 (SCL), R37.2, U1.12 (SCL)
/SDA: J6.4 (SDA), R36.2, U1.13 (SDA)
/SH1_L: K1.2 (NC1), R1.1
/SH1_R: K1.7 (NC2), R2.1
/SH2_L: K2.2 (NC1), R3.1
/SH2_R: K2.7 (NC2), R4.1
/SH3_L: K3.2 (NC1), R5.1
/SH3_R: K3.7 (NC2), R6.1
/SH4_L: K4.2 (NC1), R7.1
/SH4_R: K4.7 (NC2), R8.1

Notes on the sheet:
WEJŚCIA (JST XH, kabel ekranowany do gniazd RCA)
SELEKTOR: COM = wejście, NO = szyna, NC = 1k do masy
DRABINKA 0..63 dB co 1 dB, Z = 10 kΩ (Rs szeregowy, Rp do masy, rezystory 0,1%)
Bit 0: -1 dB (Rs 1.10k, Rp 80.6k)
Bit 1: -2 dB (Rs 2.00k, Rp 32.4k)
Bit 2: -4 dB (Rs 3.75k, Rp 17.4k)
Bit 3: -8 dB (Rs 6.20k, Rp 6.81k)
Bit 4: -16 dB (Rs 9.10k, Rp 2.00k)
Bit 5: -32 dB (Rs 10.0k, Rp 270R)
MUTE (fail-safe) + TERMINATOR + WYJŚCIE
Cewka K11 bez prądu = wyjście zwarte do masy. Dźwięk dopiero po załączeniu K11 (np. gdy lampy nagrzane i bias OK).
ZASILANIE 3,3 V: moduł DC-DC 12 V -> 3,3 V (wersja stała 3,3 V)
Pobór z 3,3 V: kilka mA (MCP23017 + pull-upy). J6 pin 3 nie jest podłączony: nie łącz 3,3 V z ESP32 z tą płytką.
STEROWANIE: MCP23017 (I2C) + 2x ULN2803A (diody gaszące wbudowane, COM -> +12V)
J6 do ESP32: 1 +12V, 2 DGND, 3 n/c, 4 SDA, 5 SCL, 6 DGND. Adres I2C: SJ1..SJ3 otwarte = 0x20 (zwarcie SJn ustawia bit An: 0x20..0x27). GPA0..7 -> K1..K8, GPB0..2 -> K9..K11 (wyjście H = cewka ON). GPB3..7 wolne. Masa cyfrowa DGND oddzielona od audio GND; R41 (0R, DNP) łączy je w jednym punkcie, jeś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
MECHANIKA / MASY
R35 (0R, DNP) łączy masę audio z obudową przez MH1. Montuj tylko jeśli masa nie jest łączona z obudową w innym miejscu.
UWAGI: 1. Biegunowość cewki G6K: pin 1 = + (+12V), pin 8 = - (do ULN2803) - potwierdzone z opisu przekaźnika. Przy montażu ustaw znacznik pinu 1 na obudowie zgodnie ze znacznikiem na sitodruku. 2. Bity drabinki: K5=1dB, K6=2dB, K7=4dB, K8=8dB, K9=16dB, K10=32dB (cewka ON = tłumienie). Zmiana głośno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

Board: 2 copper layers, 73 parts (0 on the bottom side), 74 nets, no tracks yet.
