sieraczynski-lab/Williamson-KT88/pcb/sterowanie/KiCad4_dla_EasyEDA_Standard/sterowanie.kicad_pcb

## KiCad design pcb/sterowanie/KiCad4_dla_EasyEDA_Standard/sterowanie.kicad_pcb (2026-11-12)

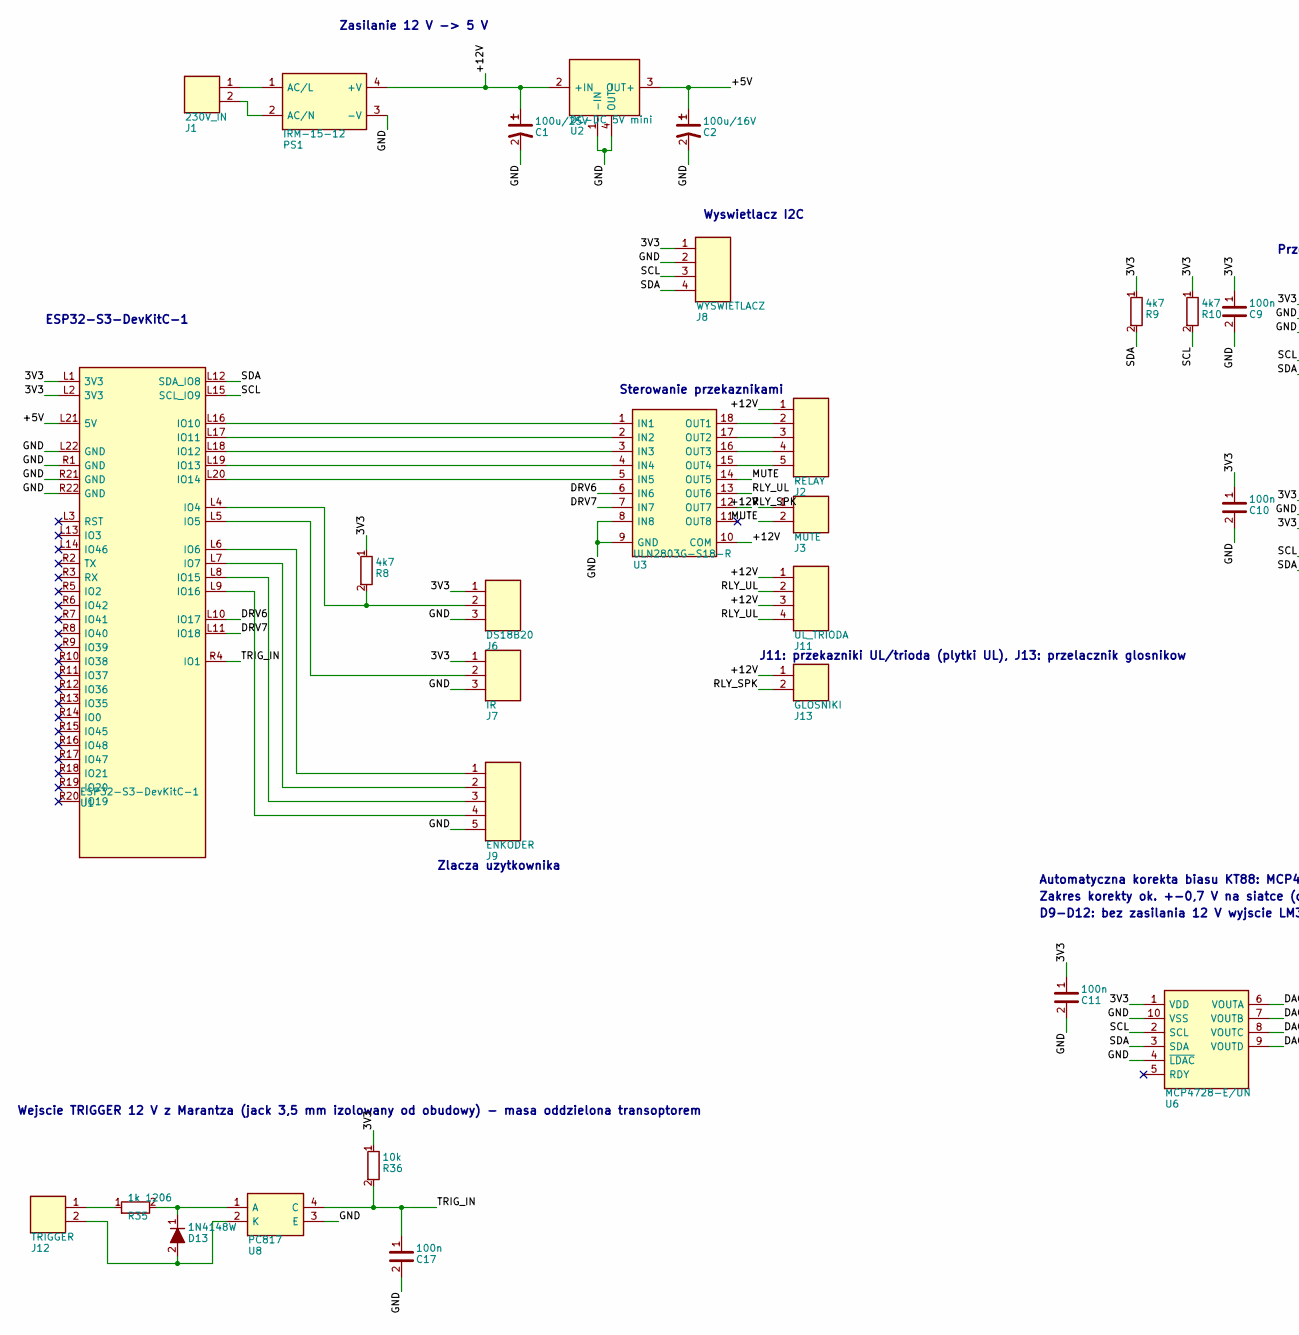
[picture p35: schematic sterowanie.sch, Soloist 88 - plytka sterowania ESP32 (SMD), part in row 1, column 1]

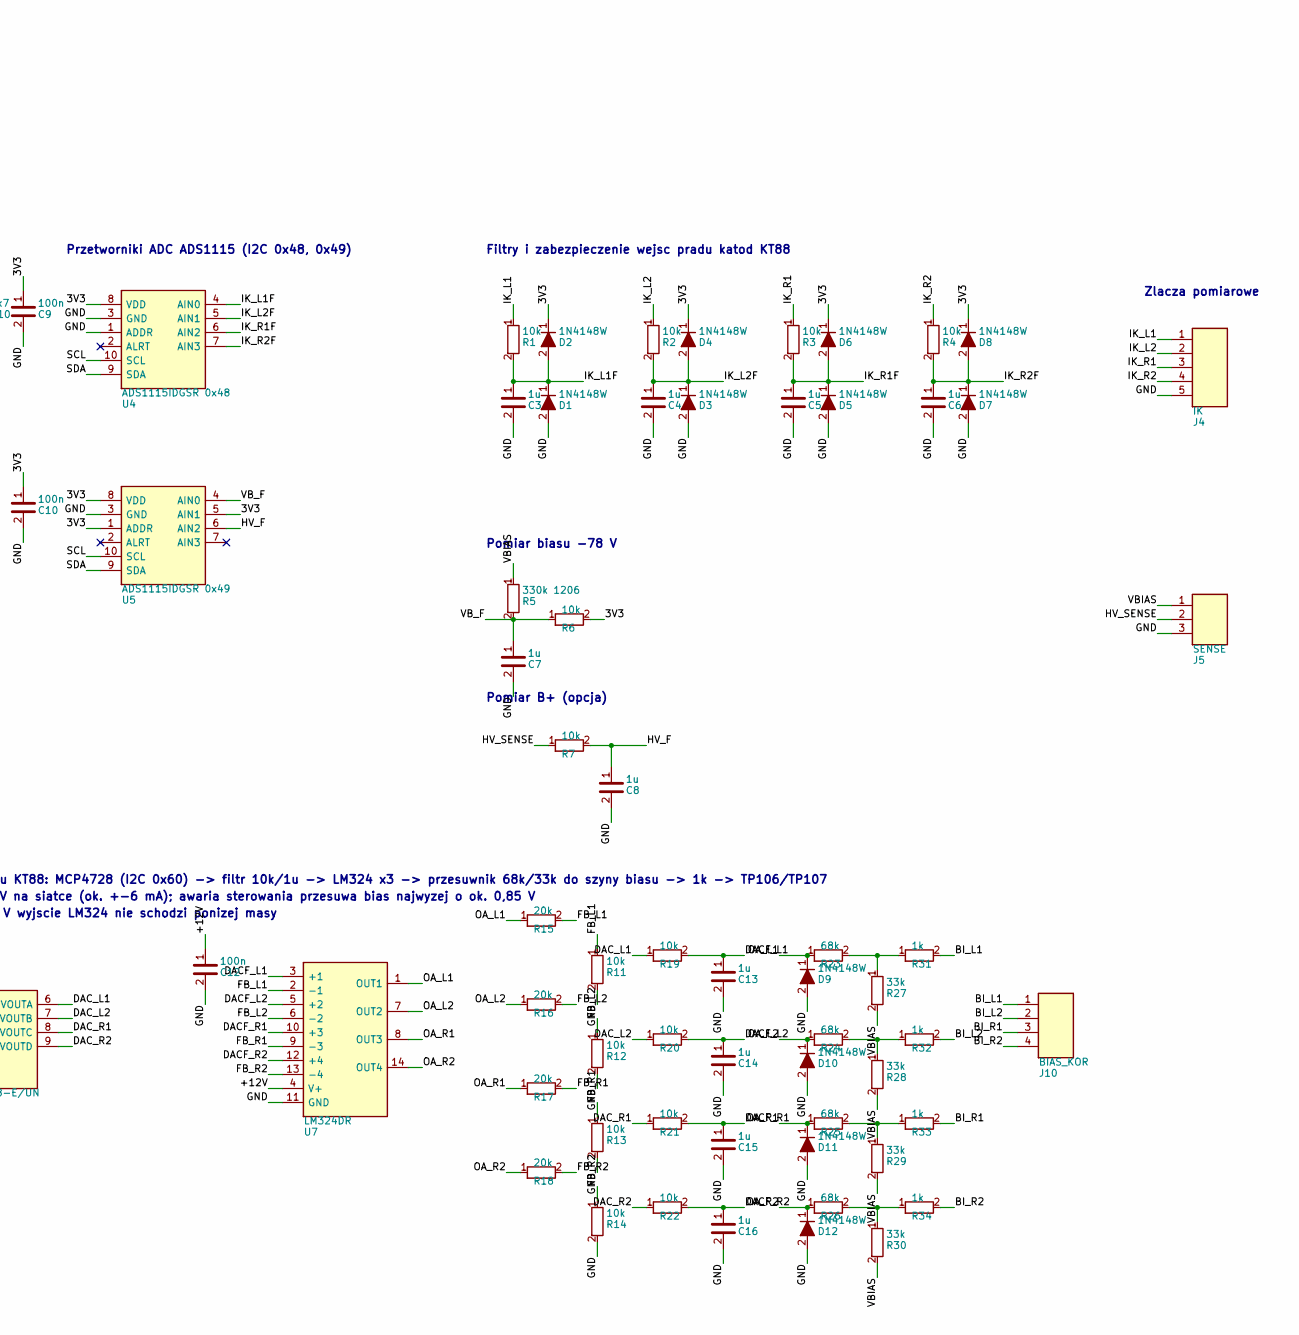
[picture p36: schematic sterowanie.sch, Soloist 88 - plytka sterowania ESP32 (SMD), part in row 1, column 2]

Parts:
C1: 100u/25V; CP_Radial_D6.3_P2.5
C2: 100u/16V; CP_Radial_D6.3_P2.5
C3, C4, C5, C6, C7, C8: 1u; C_0805_2012Metric_V
C9, C10, C11: 100n; C_0805_2012Metric
C12, C17: 100n; C_0805_2012Metric_V
C13, C14, C15, C16: 1u; C_0805_2012Metric
D1, D2, D3, D4, D5, D6, D7, D8: 1N4148W; D_SOD-123_V
D9, D10, D11, D12, D13: 1N4148W; D_SOD-123
J1: 230V_IN; TerminalBlock_1x02_P5.08
J2: RELAY; PinHeader_1x05_P2.54_H
J3: MUTE; PinHeader_1x02_P2.54_H
J4: IK; PinHeader_1x05_P2.54
J5: SENSE; PinHeader_1x03_P2.54
J6: DS18B20; PinHeader_1x03_P2.54_H
J7: IR; PinHeader_1x03_P2.54_H
J8: WYSWIETLACZ; PinHeader_1x04_P2.54_H
J9: ENKODER; PinHeader_1x05_P2.54_H
J10: BIAS_KOR; PinHeader_1x04_P2.54
J11: UL_TRIODA; PinHeader_1x04_P2.54_H
J12: TRIGGER; PinHeader_1x02_P2.54
J13: GLOSNIKI; PinHeader_1x02_P2.54_H
PS1: IRM-15-12; MeanWell_IRM-15_approx
R1, R2, R3, R4, R6, R7, R36: 10k; R_0805_2012Metric_V
R5: 330k 1206; R_1206_3216Metric_V
R8, R9, R10: 4k7; R_0805_2012Metric_V
R11, R12, R13, R14, R19, R20, R21, R22: 10k; R_0805_2012Metric
R15, R16, R17, R18: 20k; R_0805_2012Metric
R23, R24, R25, R26: 68k; R_0805_2012Metric
R27, R28, R29, R30: 33k; R_0805_2012Metric
R31, R32, R33, R34: 1k; R_0805_2012Metric
R35: 1k 1206; R_1206_3216Metric
U1: ESP32-S3-DevKitC-1
U2: DC-DC 5V mini; DCDC_5V_mini_14.17x8.24
U3: ULN2803G-S18-R; SOIC-18W_7.5x11.6mm_P1.27mm
U4: ADS1115IDGSR 0x48; MSOP-10_3x3mm_P0.5mm
U5: ADS1115IDGSR 0x49; MSOP-10_3x3mm_P0.5mm
U6: MCP4728-E/UN; MSOP-10_3x3mm_P0.5mm
U7: LM324DR; SOIC-14_3.9x8.7mm_P1.27mm
U8: PC817; DIP-4_W7.62

Connections:
3V3: C9.1, C10.1, C11.1, D2.1 (K), D4.1 (K), D6.1 (K), D8.1 (K), J6.1, J7.1, J8.1, R6.2, R8.1, R9.1, R10.1, R36.1, U1.L1 (3V3), U1.L2 (3V3), U4.8 (VDD), U5.1 (ADDR), U5.5 (AIN1), U5.8 (VDD), U6.1 (VDD)
+5V: C2.1, U1.L21 (5V), U2.3 (OUT+)
+12V: C1.1, C12.1, J2.1, J3.1, J11.1, J11.3, J13.1, PS1.4 (+V), U2.2 (+IN), U3.10 (COM), U7.4 (V+)
BI_L1: J10.1, R31.2
BI_L2: J10.2, R32.2
BI_R1: J10.3, R33.2
BI_R2: J10.4, R34.2
BTN: J9.4, U1.L9 (IO16)
DACF_L1: C13.1, R19.2, U7.3 (+1)
DACF_L2: C14.1, R20.2, U7.5 (+2)
DACF_R1: C15.1, R21.2, U7.10 (+3)
DACF_R2: C16.1, R22.2, U7.12 (+4)
DAC_L1: R19.1, U6.6 (VOUTA)
DAC_L2: R20.1, U6.7 (VOUTB)
DAC_R1: R21.1, U6.8 (VOUTC)
DAC_R2: R22.1, U6.9 (VOUTD)
DQ: J6.2, R8.2, U1.L4 (IO4)
DRV1: U1.L16 (IO10), U3.1 (IN1)
DRV2: U1.L17 (IO11), U3.2 (IN2)
DRV3: U1.L18 (IO12), U3.3 (IN3)
DRV4: U1.L19 (IO13), U3.4 (IN4)
DRV5: U1.L20 (IO14), U3.5 (IN5)
DRV6: U1.L10 (IO17), U3.6 (IN6)
DRV7: U1.L11 (IO18), U3.7 (IN7)
ENC_A: J9.1, U1.L6 (IO6)
ENC_B: J9.2, U1.L7 (IO7)
ENC_SW: J9.3, U1.L8 (IO15)
FB_L1: R11.1, R15.2, U7.2 (-1)
FB_L2: R12.1, R16.2, U7.6 (-2)
FB_R1: R13.1, R17.2, U7.9 (-3)
FB_R2: R14.1, R18.2, U7.13 (-4)
GND: C1.2, C2.2, C3.2, C4.2, C5.2, C6.2, C7.2, C8.2, C9.2, C10.2, C11.2, C12.2, C13.2, C14.2, C15.2, C16.2, C17.2, D1.2 (A), D3.2 (A), D5.2 (A), D7.2 (A), D9.2 (A), D10.2 (A), D11.2 (A), D12.2 (A), J4.5, J5.3, J6.3, J7.3, J8.2, J9.5, PS1.3 (-V), R11.2, R12.2, R13.2, R14.2, U1.L22 (GND), U1.R1 (GND), U1.R21 (GND), U1.R22 (GND), U2.1 (-IN), U2.4 (OUT-), U3.8 (IN8), U3.9 (GND), U4.1 (ADDR), U4.3 (GND), U5.3 (GND), U6.4 (~LDAC), U6.10 (VSS), U7.11 (GND), U8.3 (E)
HV_F: C8.1, R7.2, U5.6 (AIN2)
HV_SENSE: J5.2, R7.1
IK_L1: J4.1, R1.1
IK_L1F: C3.1, D1.1 (K), D2.2 (A), R1.2, U4.4 (AIN0)
IK_L2: J4.2, R2.1
IK_L2F: C4.1, D3.1 (K), D4.2 (A), R2.2, U4.5 (AIN1)
IK_R1: J4.3, R3.1
IK_R1F: C5.1, D5.1 (K), D6.2 (A), R3.2, U4.6 (AIN2)
IK_R2: J4.4, R4.1
IK_R2F: C6.1, D7.1 (K), D8.2 (A), R4.2, U4.7 (AIN3)
IR: J7.2, U1.L5 (IO5)
L_PS: J1.1, PS1.1 (AC/L)
MUTE: J3.2, U3.14 (OUT5)
N_PS: J1.2, PS1.2 (AC/N)
OA_L1: D9.1 (K), R15.1, R23.1, U7.1 (OUT1)
OA_L2: D10.1 (K), R16.1, R24.1, U7.7 (OUT2)
OA_R1: D11.1 (K), R17.1, R25.1, U7.8 (OUT3)
OA_R2: D12.1 (K), R18.1, R26.1, U7.14 (OUT4)
OPTO_A: D13.1 (K), R35.2, U8.1 (A)
RLY1: J2.2, U3.18 (OUT1)
RLY2: J2.3, U3.17 (OUT2)
RLY3: J2.4, U3.16 (OUT3)
RLY4: J2.5, U3.15 (OUT4)
RLY_SPK: J13.2, U3.12 (OUT7)
RLY_UL: J11.2, J11.4, U3.13 (OUT6)
SCL: J8.3, R10.2, U1.L15 (SCL_IO9), U4.10 (SCL), U5.10 (SCL), U6.2 (SCL)
SDA: J8.4, R9.2, U1.L12 (SDA_IO8), U4.9 (SDA), U5.9 (SDA), U6.3 (SDA)
S_L1: R23.2, R27.1, R31.1
S_L2: R24.2, R28.1, R32.1
S_R1: R25.2, R29.1, R33.1
S_R2: R26.2, R30.1, R34.1
TRIG_IN: C17.1, R36.2, U1.R4 (IO1), U8.4 (C)
TRIG_N: D13.2 (A), J12.2, U8.2 (K)
TRIG_P: J12.1, R35.1
VBIAS: J5.1, R5.1, R27.2, R28.2, R29.2, R30.2
VB_F: C7.1, R5.2, R6.1, U5.4 (AIN0)

Notes on the sheet:
ESP32-S3-DevKitC-1
Zasilanie 12 V -> 5 V
Sterowanie przekaznikami
Przetworniki ADC ADS1115 (I2C 0x48, 0x49)
Filtry i zabezpieczenie wejsc pradu katod KT88
Pomiar biasu -78 V
Pomiar B+ (opcja)
Zlacza uzytkownika
Wyswietlacz I2C
Zlacza pomiarowe
J11: przekazniki UL/trioda (plytki UL), J13: przelacznik glosnikow
Wejscie TRIGGER 12 V z Marantza (jack 3,5 mm izolowany od obudowy) - masa oddzielona transoptorem
Automatyczna korekta biasu KT88: MCP4728 (I2C 0x60) -> filtr 10k/1u -> LM324 x3 -> przesuwnik 68k/33k do szyny biasu -> 1k -> TP106/TP107
Zakres korekty ok. +-0,7 V na siatce (ok. +-6 mA); awaria sterowania przesuwa bias najwyzej o ok. 0,85 V
D9-D12: bez zasilania 12 V wyjscie LM324 nie schodzi ponizej masy

Board: 2 copper layers, 92 parts (0 on the bottom side), 68 nets, no tracks yet.

Other parts of the board:
MH1, MH2, MH3, MH4: M3; MountingHole_M3
