sieraczynski-lab/Williamson-KT88/(commit log)

2026-11-07 Williamson KT88: schematy, opis i notatki projektowe
    Szkic 1 wzmacniacza Williamson na KT88 w UL, na bazie front endu
    wersji 6S33S od onyx1944 i transformatora toroidy.pl TTG-KT88PP.
    - schematy kanału i zasilacza (SVG + strona HTML) z generatorem
    - notatki: lampy Psvane, transformatory wyjściowe, topologia,
    kolumny i zwrotnica, uruchomienie, zamawianie PCB
    Claude-Session: https://claude.ai/code/session_01LrjmpJUtMmveua3TCVcUGz
2026-11-08 Szkic 2: front end na lampach oktalowych 6SL7 + 6SN7
    Płytka Onyxa VA1523 ma wyłącznie podstawki oktalowe, więc front end
    przeliczono od nowa: 6SL7 (wejście + katodyna) i 6SN7 (driver),
    sprzężenie zwrotne z odczepu 4 Ω (ok. 21 dB, czułość ok. 0,6 V),
    rozsunięte bieguny LF, szyny 410/400 V.
    - schematy i strona HTML zaktualizowane
    - nowe notatki: wnioski ze zdjęć wersji Onyxa, specyfikacja
    transformatorów do zamówienia w toroidy.pl
    - aktualizacja notatek o transformatorach, topologii, kolumnach,
    uruchomieniu i PCB
    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
2026-11-12 Wersja 3: schemat wg płytki Onyxa VA1523 i zmiany pod toroid
    Schemat kanału i zasilacza przerysowany z układu Onyxa (2× 6SN7,
    katodyna 22k/22k, driver bez balansu, KT88 UL, zasilacz na płytce
    osobno dla każdego kanału), z wartościami zgodnymi z płytką:
    R117/R217 100k, R124/R224 10 Ω, C123/C223 niemontowane.
    - elementy do dobrania pod toroid TTG-KT88PP oznaczone na schemacie
    (R129, C123, R128, dodatkowe RL 100 Ω), NFB z odczepu 8 Ω
    - README, uruchomienie, notatki o wersjach Onyxa, specyfikacja
    transformatora sieciowego i dwóch dławików 10 H
    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
2026-11-12 Integracja z Soloistem: zasilacz, sterowanie, dodatki i obudowa
    - docs/09: zasilacz HV Soloista podaje B+3 (DC) na wejścia mostków
    płytki Onyxa, bias -80 V przez J106/J206, pomiar prądów i korekta
    biasu (punkty lutowania, zakres ±0,78 V), żarzenie, UL/trioda,
    przełącznik kolumn, selektor, zmiany w programie, lista
    "nie montować / zmienić"
    - obudowa/: wariant obudowy Soloist 0.4 z płytką Onyxa jako górnym
    pokładem pod perforowaną klatką (STEP, DXF, lista części, widoki)
    - narzedzia/obudowa/: generator i kontrole modelu
    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
    [AL_bok_lewy.dxf, AL_bok_prawy.dxf, AL_dno_400x460x3.dxf, AL_ekran_sterowania.dxf, AL_pokrywa_gorna.dxf, AL_przod_wewn.dxf, AL_trafo_dach.dxf, AL_trafo_przegroda_L.dxf]
2026-11-12 Obudowa W2: płytka Onyxa pod pokrywą zamiast klatki
    Od góry płytki są tylko podstawki, małe rezystory i potencjometry
    biasu, więc płytka wisi pod pokrywą na tulejach 10 mm, jak płytki
    kanałów Soloista. Pokrywa z otworami na podstawki, potencjometry
    (śrubokręt) i wentylację; klatka usunięta. Płytki Soloista na dnie
    przeniesione do przedniego rzędu, bo pod płytką Onyxa są kondensatory.
    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
    [AL_dno_400x460x3.dxf, AL_pokrywa_gorna.dxf, SS_klatka_bok_L_perforowana.dxf, SS_klatka_bok_P_perforowana.dxf, SS_klatka_gora_perforowana.dxf, SS_klatka_kolnierz.dxf, SS_klatka_przod_perforowana.dxf, SS_klatka_tyl_perforowana.dxf]
2026-11-12 Obudowa: podstawki 16 mm nad płytką, tuleje M3 13 mm
    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
    [Williamson_obudowa_z_elementami.step]
2026-11-12 Odpowiedzi Onyxa: TR1, sprzężenie z 8 Ω, C123 i R102/C101, rezystory katodowe
    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
2026-11-12 Własna płytka zasilacza: schemat, docs/08 i 09 pod nowy TR1 (58 V bias, odczepy 345/375 V), 2 dławiki 10 H
    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
2026-11-12 Wartości z płytki Onyxa: R101, R103, R104/C102, R111/R112, dzielnik biasu, R129 15k, R134, R136/R137, R130–R133, R143–R152; przeliczone punkty pracy, NFB, korekta biasu
    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
2026-11-12 R125/R126 150 Ω, R141/R142 47 Ω (poprawiony odczyt z płytki)
    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
2026-11-12 Dławiki: wybrane 10 H / 250 mA / 45 Ω
    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
2026-11-12 Płytka zasilacza: schemat i PCB KiCad 4/5 (EasyEDA Standard/Pro, KiCad 8), 120x100 mm, BOM, klasy sieci
    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
    [zasilacz_williamson.kicad_pcb, zasilacz_williamson.sch, zasilacz_williamson_BOM.csv, zasilacz_williamson_klasy_sieci.csv, zasilacz_williamson_netlista.csv]
2026-11-12 Płytka zasilacza 100x100 mm (R_SS/R_IN wzdłuż), klasy sieci zapisane w plikach PCB
    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
    [zasilacz_williamson.kicad_pcb, zasilacz_williamson.sch, zasilacz_williamson_BOM.csv, zasilacz_williamson_klasy_sieci.csv]
2026-11-12 Płytki z Soloista (sterowanie, UL, głośniki, selektor) i zasilacz w pcb/, połączenia dla Williamsona, opis sterowania i selektora
    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
    [BOM.csv, JLCPCB_BOM.csv, LCSC_zamowienie.csv, glosniki.kicad_pcb, glosniki.sch, glosniki_BOM.csv, glosniki_BOM_LCSC.xlsx, glosniki_klasy_sieci.csv]
2026-11-13 Jedna płytka UL/trioda na oba kanały (4x G2RL-2, 100x66), rysunek, dokumentacja i obudowa
    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
    [AL_dno_400x460x3.dxf, Williamson_obudowa.step, Williamson_obudowa_z_elementami.step, lista_czesci.csv, ul.kicad_pcb, ul.sch, ul_BOM.csv, ul_BOM_LCSC.xlsx]
